XianleZeng/Project-in-Design-2024/Documents/Gear Slection/dimensions.png

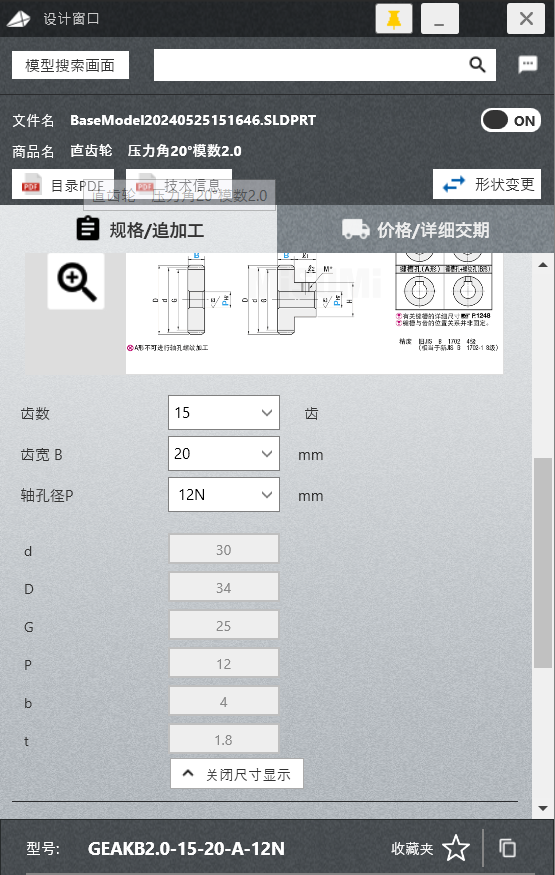
Documents/Gear Slection/dimensions.png
