XianleZeng/Project-in-Design-2024/Documents/Coupling/屏幕截图 2024-06-15 204243.png

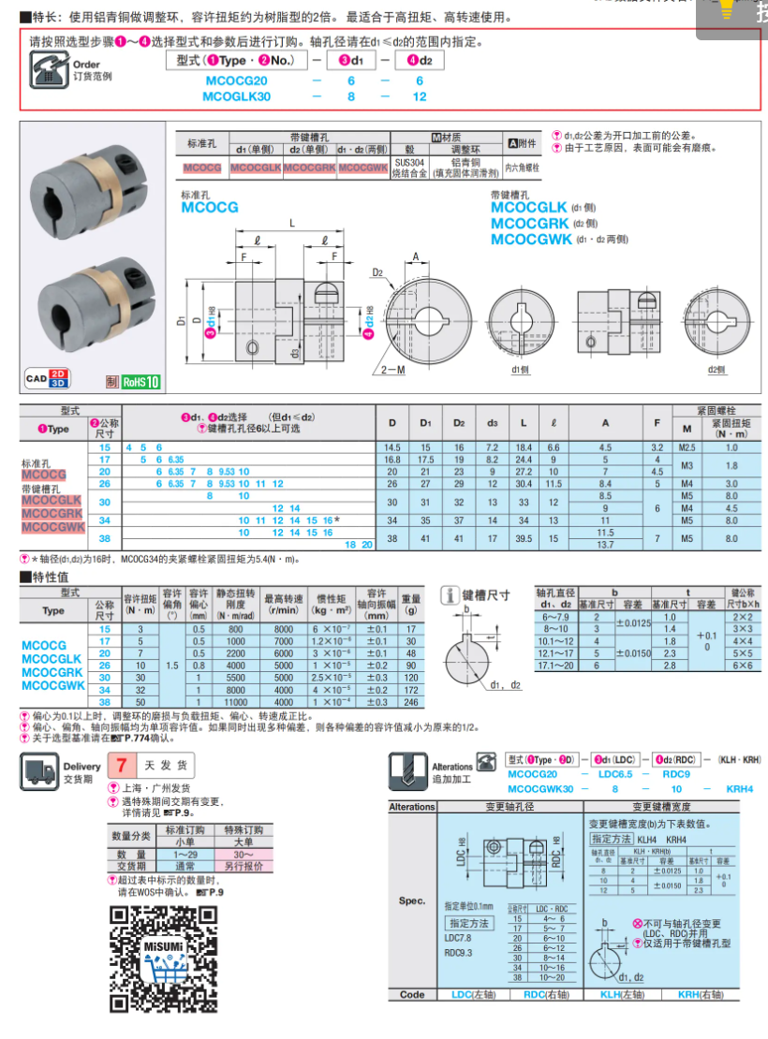
Documents/Coupling/屏幕截图 2024-06-15 204243.png
