XianleZeng/Project-in-Design-2024/Final Report.docx

Final Report – Durian Picker Machine

Yanlin Chen¹, Haojie Chen¹, Xianle Zeng¹

Abstract

# 1. Introduction

The purpose of this experiment

# 2. Concept Design

# 3. Technical Specification

# 4. Detail design

Solid modelling; Kinematics Simulation; Design Calculations (detail calc.s in appendix; reference to detail calc.s in main body of the report); FEA (description, figures of mesh(es), result contour plots, deflection plot) (group to decide how much in main body and how much in appendices and/or attached files.)

# 5. Results

# 6. Conclusion and recommendations

# 7. Reference

034057 - ADVANCED LAB IN MECH. ENG. - Spring 2024 ¹Guangdong Technion
