XianleZeng/Project-in-Design-2024/Documents/Scissor Design.docx

Scissor Design

Force analysis and dimension assume:

(Need solid work more accurate figure)

The dimension of scissor is L=250m, w=20mm, and h=10m

The force required when cutting durian branches at the bottom of scissor arm:

F=100N

And calculate the moment at the top of the scissor arm:

M_z =100[N]*250[mm]=25Nm

And then check for the yielding:

Choose the safety factor as

n = 1.5

The second moment of area:

I_z =(w^3 h)/12=(0.01^3 *0.02)/12

The first moment of area:

Q=(w/2)^2 *(h/2)=(0.02/2)(0.01/2)

Bending stress:

Normal: τ_x =-(M_z y)/(I_z)= -150 [MPa]

Shear: τ_(xz) =(VQ)/(I_z b)=3 [MPa]

And choose the 1030 HR steel for the scissor, the porosities of the material from Shigley’s book Table A-20:

The density of 1030 HR steel is 7.8g/cm^3

Since it’s a ductile material, choose Distortion-energy criterion:

σ^(') =(τ_x^2 +3τ_(xz)^2 )^(1/2) =(60^2 +3*3.75^2 )^(1/2) =150.089 [MPa]

σ^(') ≤(S_y)/(n_d)=260/1.5= 173.33 [MPa]

Thus, the beam will not yield.

From the solidwork, we get the volume of one scissor is 46713.47 mm^3 , so the mass of one scissor is:

m=ρ*V=7.8g/(cm^3)*46.713cm^3 =364.361g=0.364kg
