XianleZeng/Project-in-Design-2024/Documents/Shaft/Shaft_design.docx

Shaft Design

Force Analysis:

Free body diagram – as shown in the Figure4.1.1, Based on the FBD , the forces come from the scissors (in the x direction C_x =50N ) and gears (in the z direction D_z =850.34N ). The force on the gear comes from the motor driving the gear, and the reaction force is generated between the gears.

T=12.5Nm(From motor of one gear)

r=0.015m(From gear)

D_z =12.5/(0.98*0.015)(0.98 is the efficiency of motor)

The top end of the shaft on the right side of the diagram (point A) is connected to the motor, and there is a bearing at point B that secures the shaft on the right side. On the left side of the diagram, there are bearings at points A and B securing the shaft. Perform a force analysis on these two shafts.

On xy-plane:

{, A_x +B_x +C_x =0, C_x *AC+B_x *AG=0

A_x =12.5N B_x =37.5N

(in the left shaft the direction is along the positive x axis, in the right shaft the direction is along negative x axis)

On yz-plane

{, A_z +B_z +D_x =0, D_x *AD+B_Z *AG=0

A_x =425.17N B_x =425.17N

(in the left shaft the direction is along the negative z axis, in the right shaft the direction is along positive z axis)

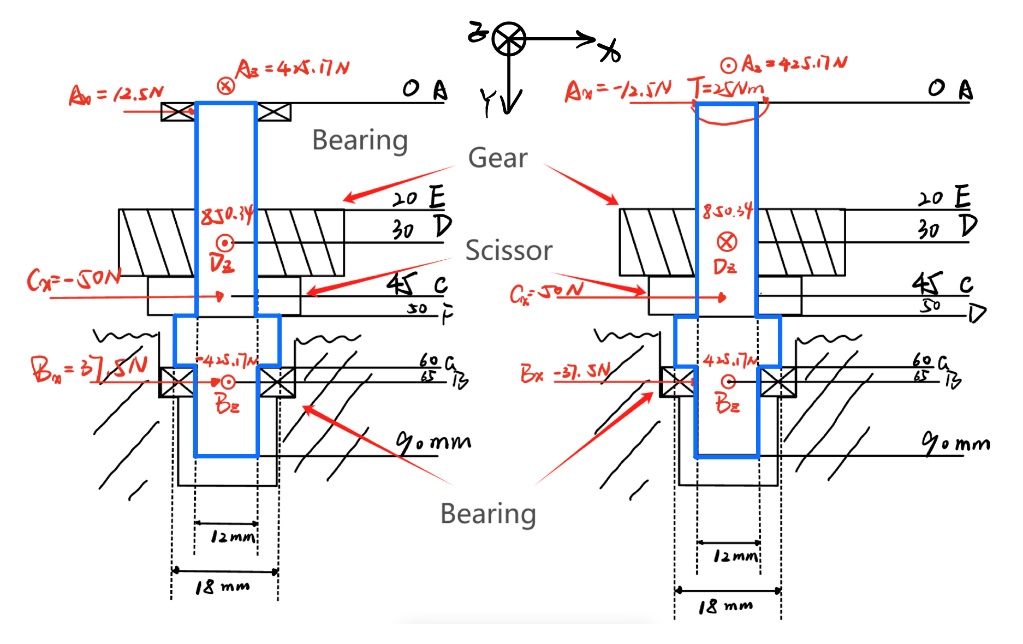
[picture p9: figure]

Figure4.1.1: Free body diagram of two shaft

After calculation of the shafts, we get the diagram of shear force and bending moment:

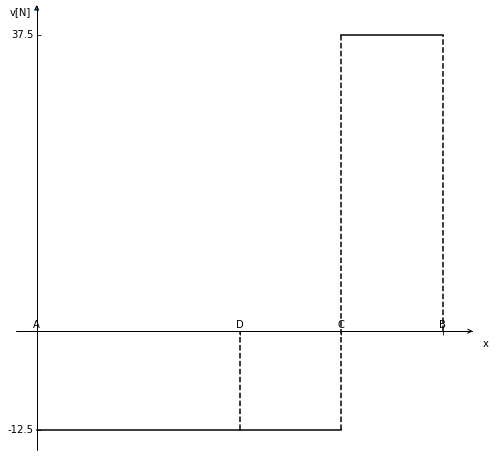
[picture p10: figure]
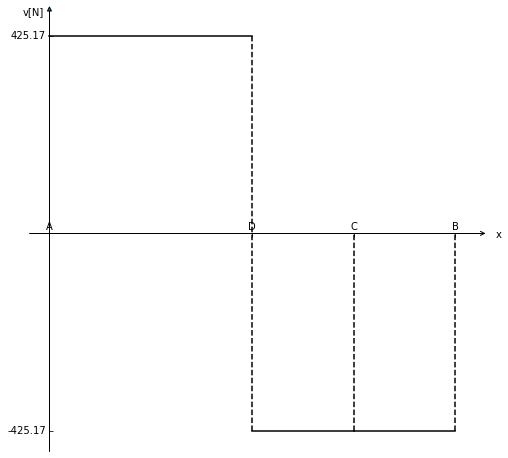
[picture p11: figure]

Figure4.1.2: shear force in xy plane | Figure4.1.3: shear force in yz plane

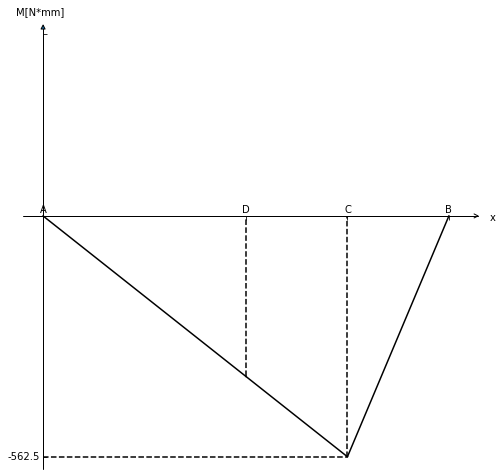
[picture p12: figure]
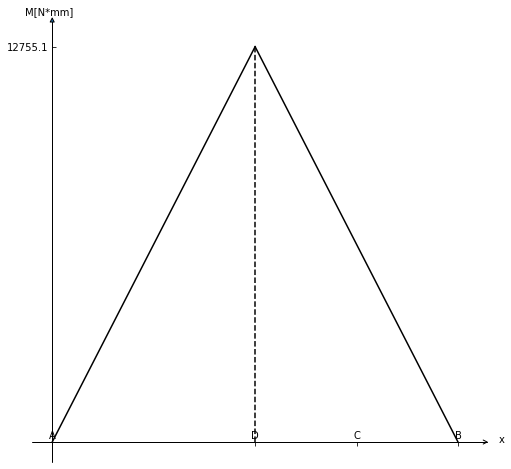
[picture p13: figure]

Figure4.1.4 Bending moment in xy plane | Figure4.1.5 Bending moment in yz plane

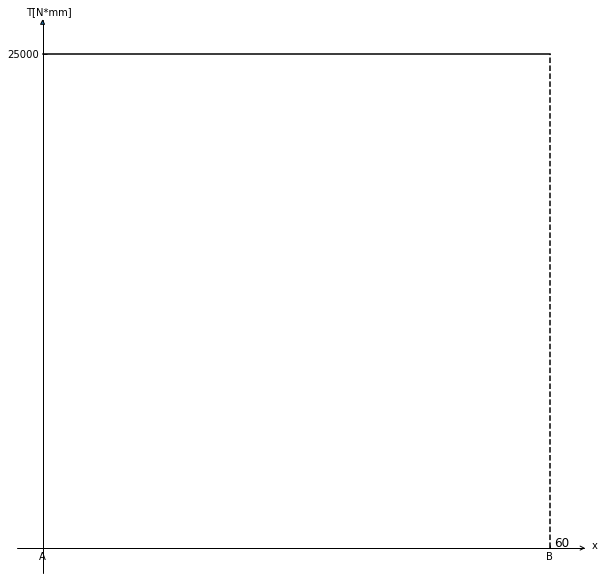
[picture p14: figure]
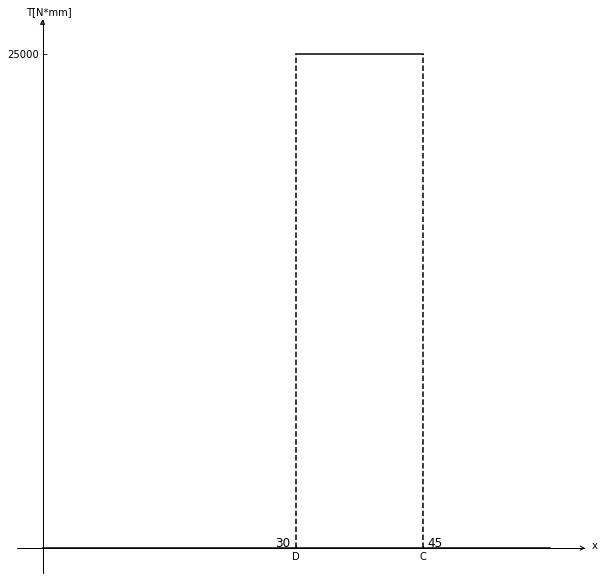
[picture p15: figure]

Figure4.1.5 Torque diagram of right shaft | Figure4.1.6 Torque diagram of left shaft

Check the shaft:

Choose the inexpensive steel, 1050CD steel, parameter is from Shigley’s book Table A-20:

S_(ut) =690MPa, S_y =580MPa

Start with point D, where the bending moment is high and there is the keyway

Forces at D:

M_(ax) = V_(AEz) ∙AE= 12755.1Nmm ; M_(mx) =0

M_(az) = V_(ACx) ∙AE= 375 Nmm ; M_(mz) =0

T_a =0Nmm; T_m =25000Nmm

Therefore,

M_a =√(M_(ax)^2 +M_(az)^2)= 12760.61 Nmm

M_m =T_a =0; T_m =25000Nmm

Based on the inner radius of the gear (12 mm), let’s design the diameter d to be 12 mm.

Assume the radius at the bottom of the keyway will be the standard r/d=0.02 , thereby

r=0.02(12)=0.24 mm

Choose the stress concentration factors from Shigley’s book

K_t =2.14 (Base on Shigley’s book Table 7-1)

K_(ts) =3.0 (Base on Shigley’s book Table 7-1)

q=0.52 (Base on Shigley’s book fig. 6-26)

q_s =0.5 (Base on Shigley’s book fig. 6-27)

From the Shigley’s book equation 6-32:

K_f =1+q*(K_t -1)=1.593

K_(fs) =1+q_s *(K_(ts) -1)=2

Then the modifying factors:

Surface factor from the Shigley’s book Table 6-2, from cold draw.

a=3.04 and b=-0.217

From equation 6-18:

k_a =aS_(ut)^b =0.731

Size factor from the Shigley’s book equation 6-19, due to the d=12mm, 7.62≤d≤51mm ,

k_b =1.24d^(-0.107) =0.95

Load factor from the Shigley’s book equation 6-25, and since there is not fluctuating axial loading, and the loading factor for torsion is already taken into account when using Mises Stress.

k_c =1

Temperature Factor the endurance limit is available or being estimated based on the ultimate strength at the operating temperature.

k_d =1

Reliability Factor

k_e =1

Estimating the Endurance Limit from equation 6-10, S_(ut) ≤1400MPa

S_e^(') =0.5S_(ut)

Finally, the endurance limit: From equation 6-17:

S_e =k_a k_b k_c k_d k_e S_e^(') =262.336MPa Use von Mises stresses from equation 7-4 and equation 7-5:

σ_a^(') =(σ_a^2 +3τ_a^2 )^(1/2) =[((32K_f M_a)/(πd^3))^2 +3((16K_(fs) T_a)/(πd^3))^2 ]^(1/2) =119.80MPa

σ_m^(') =(σ_m^2 +3τ_m^2 )^(1/2) =[((32K_f M_m)/(πd^3))^2 +3((16K_(fs) T_m)/(πd^3))^2 ]^(1/2) =255.244MPa

Then calculate the safety, using the Goodman Criterion from equation 6-41

n_f =((σ_a^('))/(S_e)+(σ_m^('))/(S_(ut)))^(-1) =1.15

And the yielding safety factor:

n_y =(S_y)/(σ_(max))=(S_y)/(σ_a^(') +σ_m^('))=1.55

At point E, there is a ring we will look up data for a specific retaining ring to obtain K_f and K_(fs) more accurately.

With a quick online search of a retaining ring specification appropriate groove specifications for a retaining ring for a shaft diameter of 11.5mm are obtained as follows: width, a=1mm; depth, 0.25mm; and corner radius at the bottom of grove, r=0.13mm

Just to the up of point E.

Forces at E:

M_(ax) = V_(AEz) ∙AE= 8503.4Nmm ; M_(mx) =0

M_(az) = V_(ACx) ∙AE= 25 Nmm ; M_(mz) =0

T_a =0Nmm; T_m =25000Nmm

Therefore,

M_a =√(M_(ax)^2 +M_(az)^2)= 8507.07 Nmm

M_m =T_a =0; T_m =25000Nmm

And

r/t=0.52

a/t=4

Choose the stress concentration factors from Shigley’s book

K_t =2.9 (Base on Shigley’s book fig.A-15-16)

K_(ts) =1.3 (Base on Shigley’s book fig.A-15-17)

q=0.51 (Base on Shigley’s book fig. 6-26)

q_s =0.55 (Base on Shigley’s book fig. 6-27)

From the Shigley’s book equation 6-32:

K_f =1+q*(K_t -1)=1.532

K_(fs) =1+q_s *(K_(ts) -1)=1.320

Then the modifying factors:

Surface factor from the Shigley’s book Table 6-2, from cold draw.

a=3.04 and b=-0.217

From equation 6-18:

k_a =aS_(ut)^b =0.731

Size factor from the Shigley’s book equation 6-19, due to the d=12mm, 7.62≤d≤51mm ,

k_b =1.24d^(-0.107) =0.95

Load factor from the Shigley’s book equation 6-25, and since there is not fluctuating axial loading, and the loading factor for torsion is already taken into account when using Mises Stress.

k_c =1

Temperature Factor the endurance limit is available or being estimated based on the ultimate strength at the operating temperature.

k_d =1

Reliability Factor

k_e =1

Estimating the Endurance Limit from equation 6-10, S_(ut) ≤1400MPa

S_e^(') =0.5S_(ut)

Finally, the endurance limit: From equation 6-17:

S_e =k_a k_b k_c k_d k_e S_e^(') =239.742MPa

Use von Mises stresses from equation 7-4 and equation 7-5:

σ_a^(') =(σ_a^2 +3τ_a^2 )^(1/2) =[((32K_f M_a)/(πd^3))^2 +3((16K_(fs) T_a)/(πd^3))^2 ]^(1/2) =57.82MPa

σ_m^(') =(σ_m^2 +3τ_m^2 )^(1/2) =[((32K_f M_m)/(πd^3))^2 +3((16K_(fs) T_m)/(πd^3))^2 ]^(1/2) =168.46MPa

Then calculate the safety, using the Goodman Criterion from equation 6-41

n_f =((σ_a^('))/(S_e)+(σ_m^('))/(S_(ut)))^(-1) =2.06

And the yielding safety factor:

n_y =(S_y)/(σ_(max))=(S_y)/(σ_a^(') +σ_m^('))=2.56

And then check for point C, here the bending moment is high and there is a stress concentration of the shoulder.

Forces at C:

M_(az) = V_(ACx) ∙AC= 562.5 Nmm ; M_(mx) =0

M_(ax) = V_(DBx) ∙AC+12755.1= 6377.55 Nmm ; M_(mz) =0

T_a =0; T_m =25000Nmm

Therefore,

M_a =√(M_(ax)^2 +M_(az)^2)= 6402.31 Nmm

M_m =T_a =0; T_m =25000Nmm

Based on the inner radius of the gear (12 mm), let’s design the diameter d to be 12 mm.

Next, check for failure:

Choose diameter ratio for the shoulder: D/d = 1.5, thereby

D=1.5(12)=18 mm

Select standard value D = 18 mm.

Check if estimates were acceptable:

D/d=1.5→OK

Choose fillet ratio r/d=0.1 for well-rounded shoulder, based on Shigley’s book [Table 7-1].

So the fillet radius is r=0.1*d=1.2mm .

Choose the stress concentration factors from Shigley’s book

K_t =1.7 (Base on Shigley’s book fig. A-15-9)

K_(ts) =1.4 (Base on Shigley’s book fig. A-15-8)

q=0.76 (Base on Shigley’s book fig. 6-26

q_s =0.8 (Base on Shigley’s book fig. 6-27

From the Shigley’s book equation 6-32:

K_f =1+q*(K_t -1)=1.532

K_(fs) =1+q_s *(K_(ts) -1)=1.319

Then the modifying factors:

Surface factor from the Shigley’s book Table 6-2, from cold draw.

a=3.04 and b=-0.217

From equation 6-18:

k_a =aS_(ut)^b =0.731

Size factor from the Shigley’s book equation 6-19, due to the d=12mm, 7.62≤d≤51mm ,

k_b =1.24d^(-0.107) =0.95

Load factor from the Shigley’s book equation 6-25, and since there is not fluctuating axial loading, and the loading factor for torsion is already taken into account when using Mises Stress.

k_c =1

Temperature Factor the endurance limit is available or being estimated based on the ultimate strength at the operating temperature.

k_d =1

Reliability Factor

k_e =1

Estimating the Endurance Limit from equation 6-10, S_(ut) ≤1400MPa

S_e^(') =0.5S_(ut)

Finally, the endurance limit: From equation 6-17:

S_e =k_a k_b k_c k_d k_e S_e^(') =239.742MPa Use von Mises stresses from equation 7-4 and equation 7-5:

σ_a^(') =(σ_a^2 +3τ_a^2 )^(1/2) =[((32K_f M_a)/(πd^3))^2 +3((16K_(fs) T_a)/(πd^3))^2 ]^(1/2) =57.816MPa

σ_m^(') =(σ_m^2 +3τ_m^2 )^(1/2) =[((32K_f M_m)/(πd^3))^2 +3((16K_(fs) T_m)/(πd^3))^2 ]^(1/2) =168.46MPa

Then calculate the safety, using the Goodman Criterion from equation 6-41

n_f =((σ_a^('))/(S_e)+(σ_m^('))/(S_(ut)))^(-1) =2.061

And the yielding safety factor from equation 7-7:

n_y =(S_y)/(σ_(max))=(S_y)/(σ_a^(') +σ_m^('))=2.563

Finally, let us check for deflection:

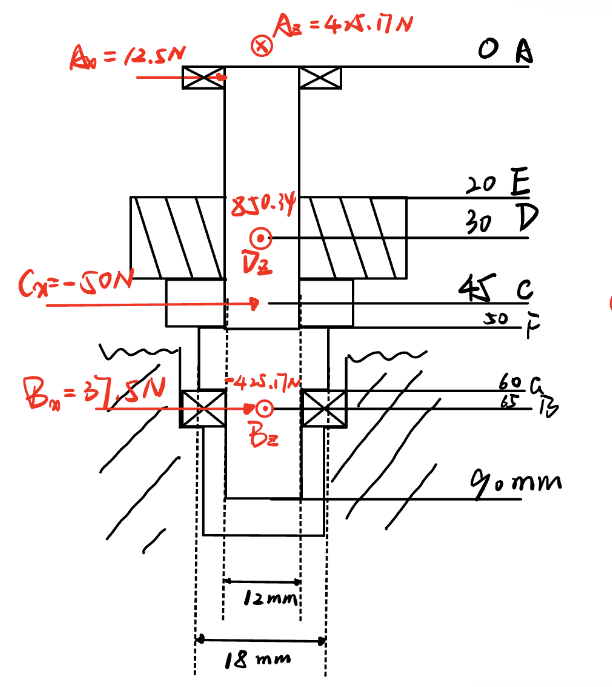
[picture p16: figure]

For simplification, let’s assume diameter from F to G is equal to OF, this is more conservative.

In xy plane, For boundary condition:

v_(AC) (0)=0

v_(AC) (at C)=v_(CB) (at C)=0

v_(AC)^(') (at C)=v_(CB)^(') (at C)

v_(AB) (at B)=0

Integrate the moment functions:

EI_1 (dv_1)/(dx)=∫ M_1 dx+C_1

EI_2 (dv_2)/(dx)=∫ M_2 dx+C_2

EI_1 v_1 =∫ EI_1 (dv_1)/(dx)dx+C_3

EI_2 v_2 =∫ EI_2 (dv_2)/(dx)dx+C_4

And d_1 =d_2 =12mm , I_1 =(πd_1^4)/64 and I_2 =(πd_2^4)/64

So, there is four equations and four unknowns, use python to solve:

v_1 =-9.9841*10^(-9) *x^3 + 2.0218*10^(-5) *x

v_2 =2.9952*10^(-8) *x^3 - 5.3914*10^(-6) *x^2 + 0.0002628*x - 0.00283

(dv_1)/(dx)= - 2.9952*10^(-8) *x^2 +2.0217*10^(-5)

(dv_2)/(dx)=8.9857*10^(-8) *x^2 - 1.0783*10^(-5) *x + 0.00026

In xz plane, For boundary condition:

v_(AD) (0)=0

v_(AD) (at D)=v_(DB) (at D)=0

v_(AD)^(') (at D)=v_(AD)^(') (at D)

v_(AB) (at B)=0

Therefore, use python to solve:

v_1 =3.39596041*10^(-7) *x^3 - 0.0003056*x

v_2 =-3.39596*10^(-7) *x^3 + 6.11272*10^(-5) *x^2 - 0.002139*x - 0.01833

(dv_1)/(dx)=1.01878812*10^(-6) *x^2 - 0.0003056

(dv_2)/(dx)=-1.01878812*10^(-6) *x^2 + 0.00012225*x - 0.00213946

Table4.1.1: Slope and Deflection Values at key Locations

Point of interest | XY Plane | XZ Plane | Total
Gear slope (D) | 6.739284514*10^(-6) [rad] | 0.00061127 [rad] | 0.00061131[rad]
Bearing slope (B) | 6.065356062*10^(-5) [rad] | 0.00152818 [rad] | 0.00152938[rad]
Gear deflection (D) | 0.00033[mm] | 0.000169[mm] | 0.00037[mm]

The deflections and slopes at points of interest are obtained from the calculation, and combined with orthogonal vector addition, that is, (δ_(XY)^2 +δ_(XZ)^2 )^(1/2) . Results are shown in Table4.1.1 And according to the guidelines in Table 7-2 in Shigley’s book. It is satisfied for the requirement.
