XianleZeng/Project-in-Design-2024/Documents/Beam/Beam_Design.docx

Beam Design:

Free body diagram:

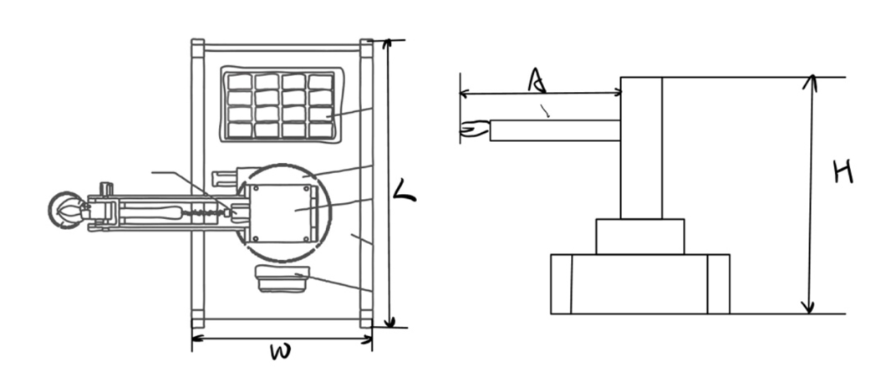
[picture p17: figure]

Force analysis:

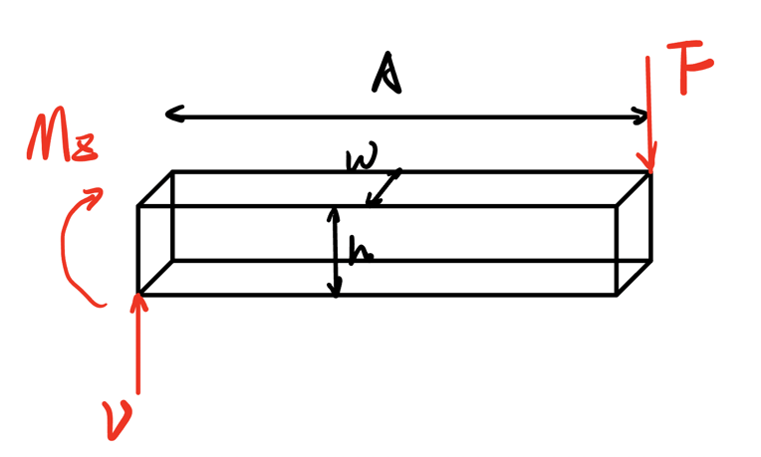
[picture p18: figure]

F_(mass) =F_(box) +F_(motor) +F_(shaft+gear+scissor) =185.423 [N]

To be more conservative, we magnify it by a factor γ=1.5 .

F=γF_(mass) =185.423*1.5=278.134 [N]

Force Diagram:

Point D is the critical point since the bending moment at this point is highest and there is a stress concentration of the guide rail.

The internal moment and the shear force at the critical point:

V = F

M_z =V*A=417.201 [Nm]

Let’s choose G10300 HR steel as the material from Shigley’s book Table A-20, the properties:

Assume the dimension of the beam:

Thickness: h = 0.25 m

Width: b = 0.25 m

Let’s check for the yielding:

Choose the safety factor as

n = 1.3

Bending stress:

Normal: τ_x =-(M_z y)/(I_z)= -160.205 [MPa]

Shear: τ_(xz) =(VQ)/(Ib)=6.675 [MPa]

Since it’s a ductile material, choose Distortion-energy criterion:

σ^(') =(τ_x^2 +3τ_(xz)^2 )^(1/2) = 160.344 [MPa]

σ^(') ≤(S_y)/(n_d)=260/1.3= 200 [MPa]

Thus, the beam will not yield.
