XianleZeng/Project-in-Design-2024/Final/Presentation.pptx

## Durian Picker Mechine

034371 - PROJECT IN DESIGN FOR MANUFACTURING - Spring 2024
Yanlin Chen; Haojie Chen; Xianle Zeng

## Slide 2

Introduction

## Slide 3

Concept Design

## Slide 4

Technical Specification

## Slide 5

Detail Design

## Slide 6

Detail Design: Cutter

## Slide 7

Detail Design: Gear

## Slide 8

Detail Design: …

## Slide 9

Detail Design: …

## Slide 10

Results

## Slide 11

Conclusion and Recommendations
