XianleZeng/Project-in-Design-2024/Documents/Gear Slection/Spur-Gear Selection.docx

3.10. Gear Selection

Spur Gear Selection Flow Chart

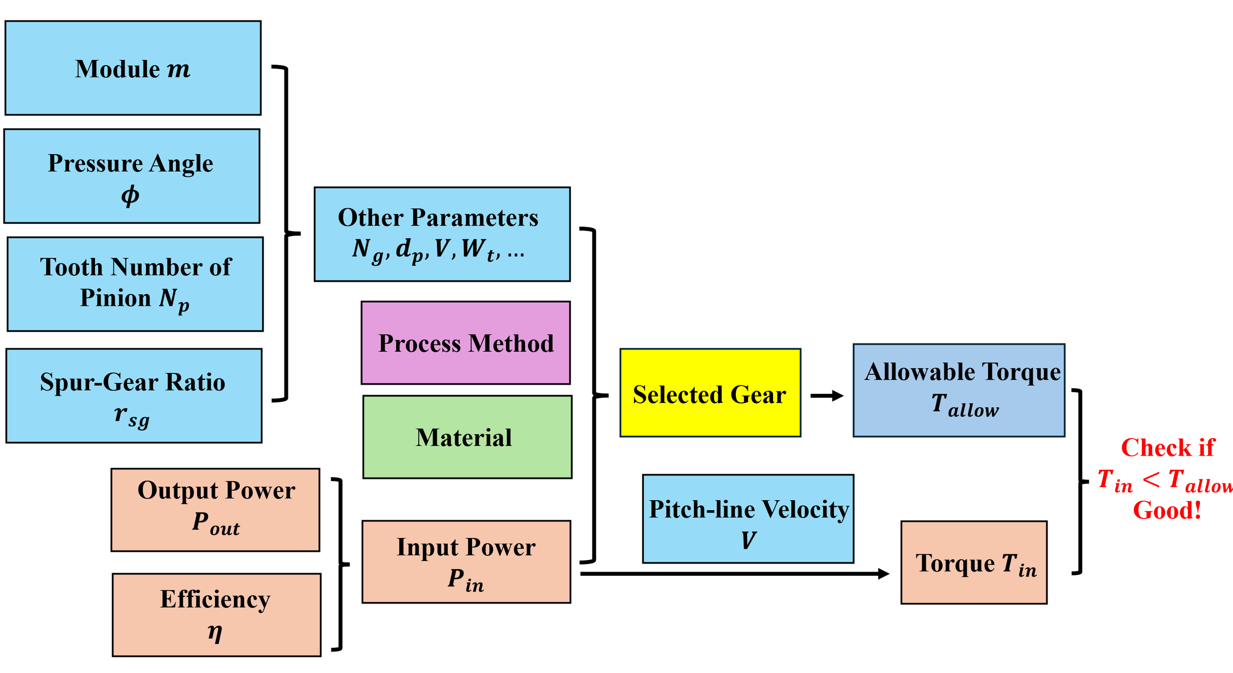
[picture p32: figure]

Figure 3.10.1: Durian picker machine end-effector spur-gear selection flow chart.

Power Relationships of Spur Gear and End-effector

Since we lack an exact cut-off force value about the durian branch, here we assign a significantly sufficient value 50N to the cut-off force F_(cut) ensuring that desired motion is achieved. The durian picking task is not strict with the speed requirements of the end-effectors, therefore we select a nice angular speed to fit our need, which represents the end-effector rotating π/2 rads in 1 seconds, i.e., w=(π/2)/1=1.570796 rads/sec . Length of end-effector is l=0.25 m . Power applied on the end-effector is 19.634954 W . Considering that power losses between pinion, and that gear and its efficiency generally varies between 0.98~1 , we choose an efficiency coefficient η=0.98 . Thus, the power subjected to the pinion is known as 20.035667 W .

, P_(out) =F_(cut) lw= 19.634954 W

, P_(in) =(P_(out))/η=20.035667 W

Teeth Number Determination of Spur Pinion and Gear

When two gears are in mesh, it is possible that an involute portion of one will contact a non-involute portion of the other gear. This phenomenon is known as "interference" and occurs when the number of teeth on the smaller of the two meshing gears is less than a required minimum.

The Determination of Teeth Number of Spur Pinion Without Interference

To avoid the interference between gears, it is necessary to determine the smallest teeth number of spur pinion (refer to Shiley eq.13-10), where k=1 for full-depth teeth and ϕ=20° is the pressure angle we decide. Then we find that the smallest teeth number of the spur pinion without interference is 13. For safety consideration, a considerable teeth number of gears is more welcome in our design. Therefore, we choose the teeth number of spur-gear is N_p =15 .

, N_(p,min) =(2k)/(3sin^2 (ϕ))(1+√(1+3sin^2 (ϕ)))=(2∙1)/(3sin^2 (20°))(1+√(1+3sin^2 (20°)))=12.3=13#

N_p =15

The Determination of Teeth Number of Gear Without Interference

Since the teeth number of gear cannot be infinite, the maximum teeth number of gear is determined with the help of Shigley eq.13-12.

N_(G,max) =(N_p^2 sin^2 ϕ-4k^2)/(4k-2N_p sin^2 ϕ)=(15^2 sin^2 20°-4(1)^2)/(4(1)-2(15)sin^2 20°)=45

It means that if the teeth number of gear does not exceed 45, then the selected gear will not encounter interference phenomena. Since we set the spur-gear ratio is 1, the teeth number of the gear should be the same as pinion’s, i.e., 15.

N_G =15

Theoretical Torque Calculation

Before we realize the theoretical torque applied to the pinion, we need to know the pitch-line velocity V and tangent force W_t between the gearset.

Pitch-line Velocity

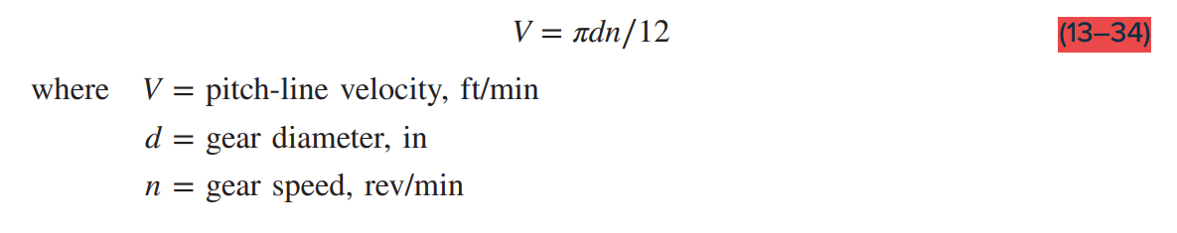
[picture p33: figure]

d_p =N_p m=15(2)=30 mm

V=1/1000∙(πd_p)/w=1/1000∙(π(30))/1.570796=0.023562 m/sec

Tangent Force

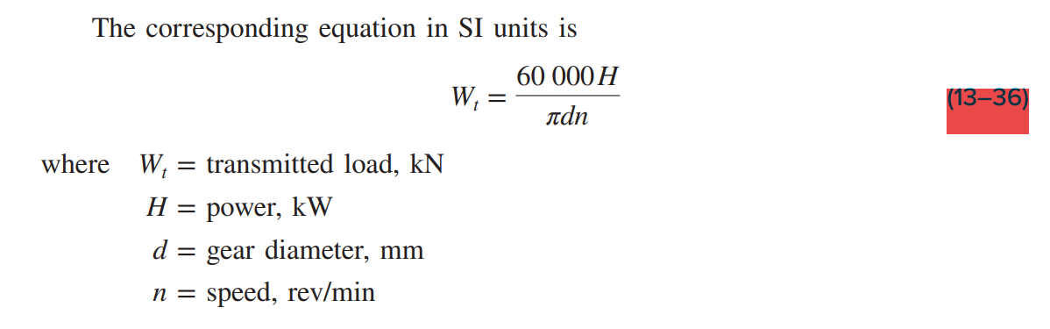
[picture p34: figure]

W_t =(P_(in))/V=20.035667/0.023562=850.340136 N

Theoretical Torque Applied to the Pinion

T_(theo) =W_t (d_p)/2=850.340136∙((30/1000)/2)=12.755102 Nm

Spur-Gear Selection

A gearset (GEAKB2.0-15-20-A-12N) provided by a Japanese company, MiSUMi, fit our need. Here are all relevant parameters. m [mm], N_T , W_T [mm] and T_(allow) [Nm] represent module, teeth number, teeth width, and allowable torque respectively.

Table 3.10.1: Spur-Gear Parameters.

m [mm] | N_T | W_T [mm] | Key Size | Material | Specific Process | T_(allow) [Nm]
2 | 15 | 20 | 12N | S45C | / | 28.65

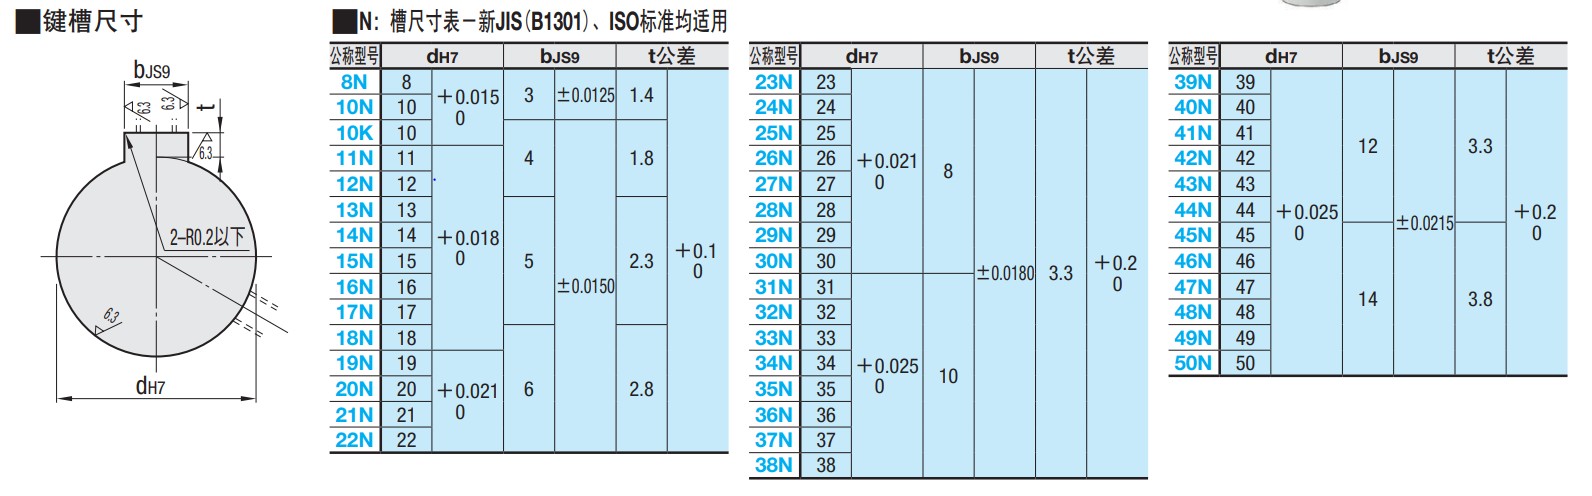
[picture p35: figure]

Figure 3.10.2: Tolerance of the keyway.

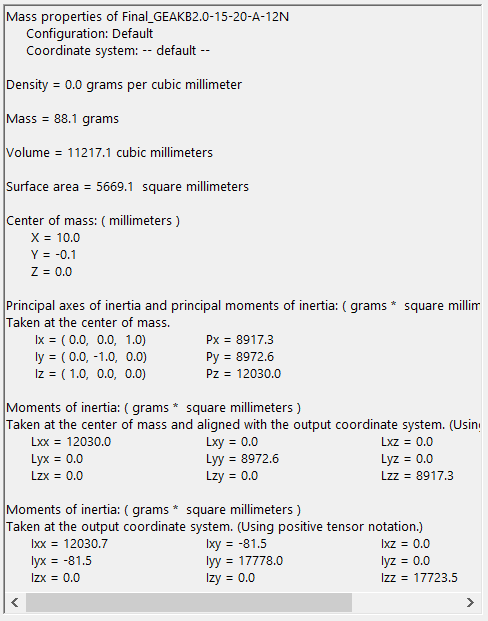
[picture p36: figure]

Figure 3.10.3: Other information about the gear.

Examine the Failure of Gearset

Refer to Table 3.10.1, we know the allowable torque T_(allow) tested in experiment from MiSUMi company, then we can compare the allowable torque T_(allow) and the theoretical torque we calculated T_(theo) . If the theoretical torque T_(theo) is smaller than the allowable torque T_(allow) , we successfully select the gear. Otherwise, we need to choose a new one.

T_(theo) =12.755102 Nm<28.65 Nm=T_(allow)

We successfully chose a desired gear, which is GEAKB2.0-15-20-A-12N!

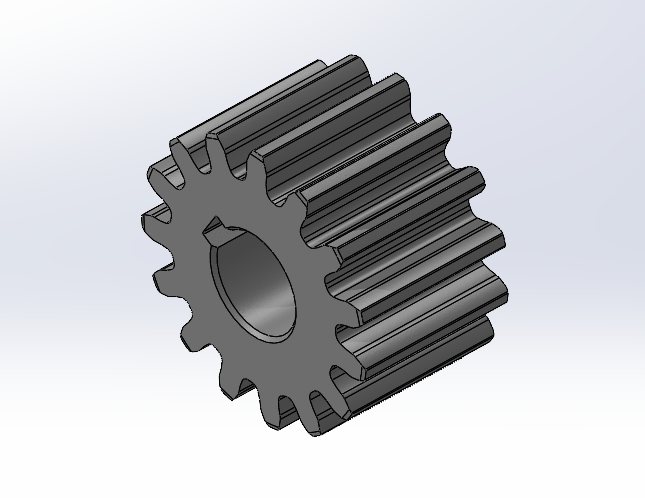
[picture p37: figure]

Figure 3.10.4: Spur-Gear GEAKB2.0-15-20-A-12N (MiSUMi).
