XianleZeng/Project-in-Design-2024/Documents/Bearing Selection/Bearing Selection.docx

Bearing Selection:

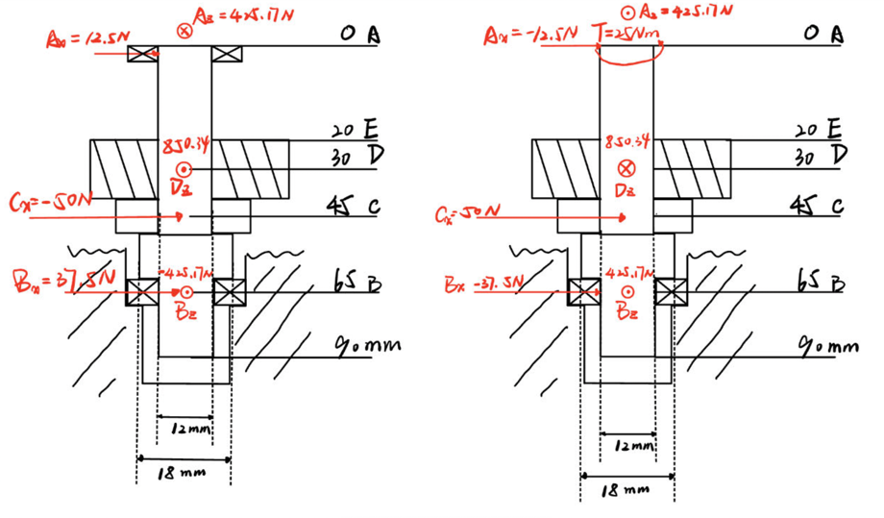
[picture p38: figure]

Figure 1 Shaft Layout

For the bearing at B on the left shaft:

1. Performance and operating condition:

Table 1 Performance and operating condition for the bearing at B on the left shaft

Radical Force ( F_r =√(B_x^2 +B_z^2) ) | 426.82 [N]
Axial Force ( F_a ) | 7.487 [N]
Speed | 15 [rpm]
Operating Condition | 50 [degree]
Required rating life* | 20000 [h]

* Let’s say the machine operate 40 h for one week and operate 48 weeks per year. If we want it to work for 10 years, then the total life is (48)(40)(10)= 19200≈20000 h .

2. Bearing type and arrangement:
- Locating bearing is used since the bearing B need to carry the weight of the shaft, the gear and the cutter.
- Deep groove ball bearings are selected because they have the capability to carry both axial and radical force.
3. Bearing Size:

The inner radius of the shaft is 12 mm, thereby the inner radius of the bearing should align with it. Then, choose the 6201 deep groove ball bearing from SKF company.

4. Technical Specification:

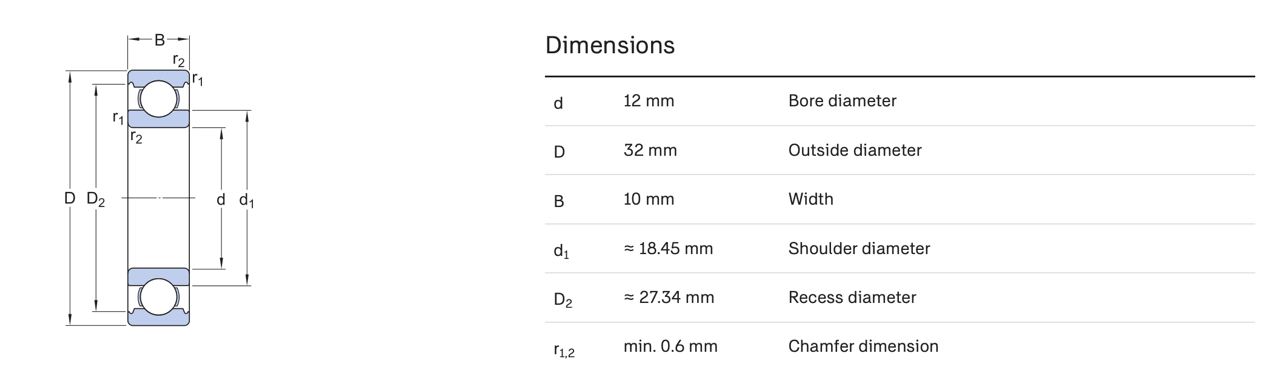
[picture p39: figure]

Figure 2 Technical specification of 6201 deep groove ball bearing from SKF company

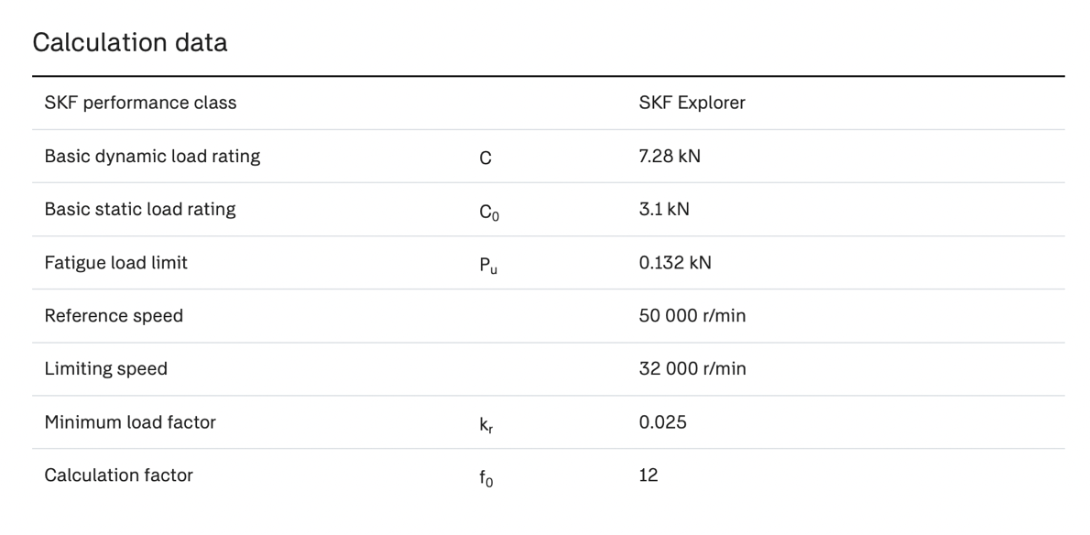
[picture p40: figure]

Figure 3 Calculation data of 6201 deep groove ball bearing from SKF company

5. Basic rating life:

From the data sheet for 6201 deep groove ball bearing, the calculation factor:

f_0 =12

(f_0 F_a)/(C_0)=(12∙0.42682)/3.1=1.6522

From Table 10, P257, SKF handbook, e = 0.34, and:

(F_a)/(F_r)=0.0175<e

According to Page 254 in SKF handbook,

P=F_A =426.82 [N]

L_(10h) =((10^6)/(60n))(C/P)^p =((10^6)/(60(15)))(7.28/0.43)^(10/3) =398,4000 [h]> 20000[h]

which satisfies our requirement.

6. Lubrication:

Input Values:

d_m =0.5(12+32)=22 [mm]

nd_m =15∙22=330 [mm/min]

n= 15 [rpm]

C/P= 7.28/0.43=16.93

From SKF handbook, Table 1, Page 113,

b_f =1

The nd_m limit is 100000, which is greater than 210.

Grease selection criteria:

- Temperature: 50 -> M
- Speed: nd_m =330 -> L
- Load: C/P = 16.93 -> L

From the SKF bearing grease selection chart, page 124, LGWM2 grease is selected since the bearing operates at low speed.

nd_m b_f = 330

From SKF handbook, Diagram 2 Page 112, the relubrication intervals at operating temperatures of 70 °C is:

t_(f@70℃) =25000 [h] <20000 [h]

This satisfies the requirement.

For the bearing at B on the right shaft:

1. Performance and operating condition:

Table 2 Performance and operating condition for the bearing at B on the right shaft

Radical Force ( F_B =√(B_x^2 +B_z^2) ) | 426.82 [N]
Axial Force | 0 [N]
Speed | 15 [rpm]
Operating Condition | 50 [degree]
Required rating life* | 20000 [h]

2. Bearing type and arrangement:
- Non-locating bearing is used since the bearing A only carry the radical load.
- Needle bearing is used.
3. Bearing Size:

The inner radius of the shaft is 12 mm, thereby the inner radius of the bearing should align with it. Then, choose the HK 1210 E needle roller bearing from SKF company.

4. Technical Specification:

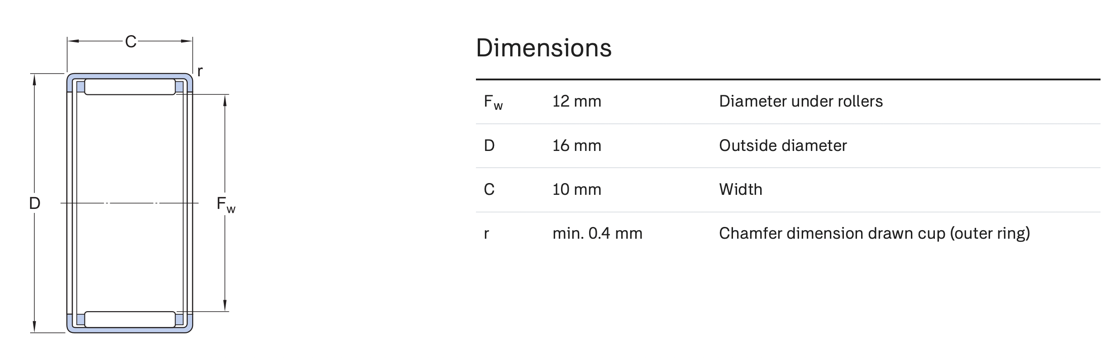
[picture p41: figure]

Figure 4 Technical specification of HK 1210 E needle roller bearing from SKF company.

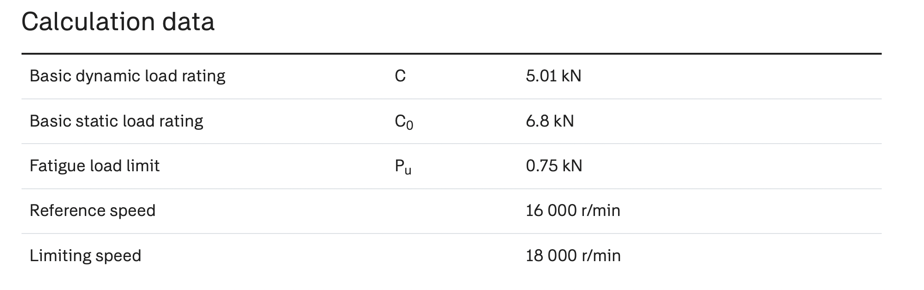
[picture p42: figure]

Figure 5 Calculation data of HK 1210 E needle roller bearing from SKF company.

5. Basic rating life:

P=F_A =426.82 [N]

L_(10h) =((10^6)/(60n))(C/P)^p =((10^6)/(60(15)))(5.01/0.43)^(10/3) =398,4000 [h]> 20000[h]

which satisfies our requirement.

6. Lubrication:

Input Values:

d_m =0.5(12+16)=14 [mm]

nd_m =15∙14=210 [mm/min]

n= 15 [rpm]

C/P= 5.01/0.43=11.65

From SKF handbook, Table 1, Page 113,

b_f =3

The nd_m limit is 100000, which is greater than 210.

Grease selection criteria:

- Temperature: 50 -> M
- Speed: nd_m =210 -> L
- Load: C/P = 11.65 -> M

From the SKF bearing grease selection chart, page 124, LGEV2 grease is selected since the bearing operates at low speed.

nd_m b_f = 630

From SKF handbook, Diagram 2 Page 112, the relubrication intervals at operating temperatures of 70 °C is:

t_(f@70℃) =10050 [h]

Since the operating temperature in this project is 50℃ , based on SKF handbook, table 2, we need to adjust the interval by double it, therefore,

t_(f@50℃) =20100 [h]<20000 [h]

This satisfies the requirement.

For the bearing at A on the left shaft:

1. Performance and operating condition:

Table 3 Performance and operating condition for the bearing at A on the left shaft

Radical Force ( F_A = √(A_x^2 +A_y^2) ) | 425.35 [N]
Axial Force | 0 [N]
Speed | 15 [rpm]
Operating Condition | 50 [degree]
Required rating life* | 20000 [h]

* Let’s say the machine operate 40 h for one week and operate 48 weeks per year. If we want it to work for 10 years, then the total life is (48)(40)(10)= 19200≈20000 h .

Since the performance and operating condition is similar with the Bearing B of the right shaft with a lower radical force, we can use the same bearing here. Therefore, we choose HK 1210 E needle roller bearing from SKF company for this shaft.
