XianleZeng/Project-in-Design-2024/Documents/Gear Slection/dataset1.PNG

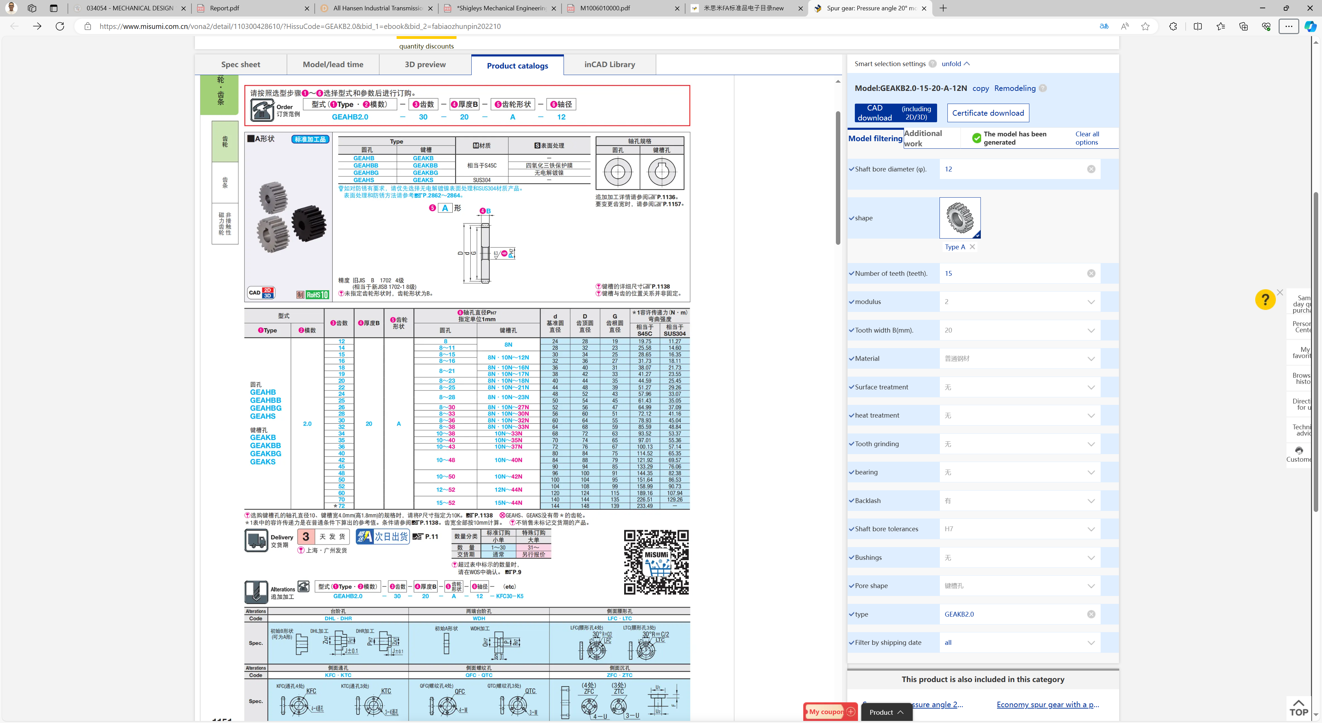
Documents/Gear Slection/dataset1.PNG
