XianleZeng/Project-in-Design-2024/Documents/Gear Slection/Flow Chart.PNG

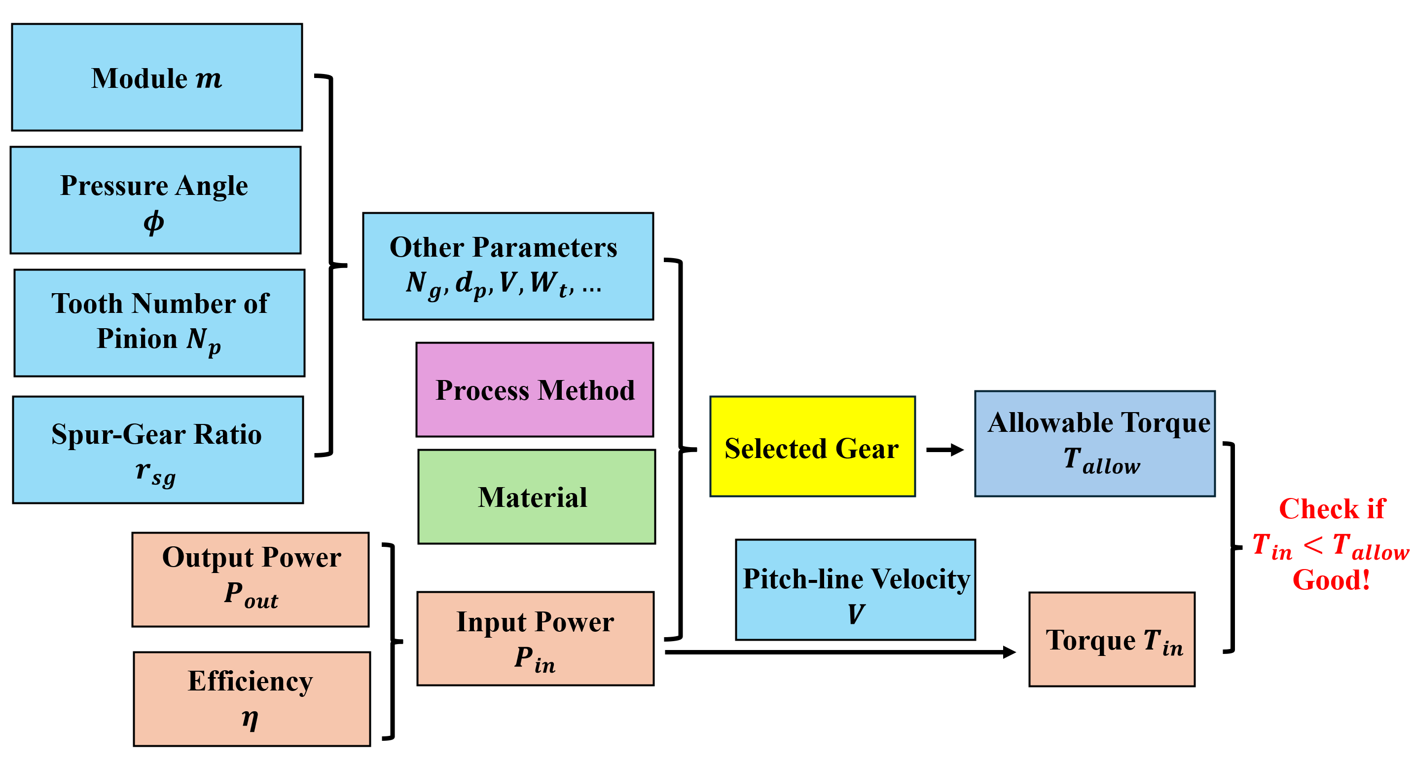
Documents/Gear Slection/Flow Chart.PNG
