XianleZeng/Project-in-Design-2024/Documents/Gear Slection/Gear_density_volume_mass.PNG

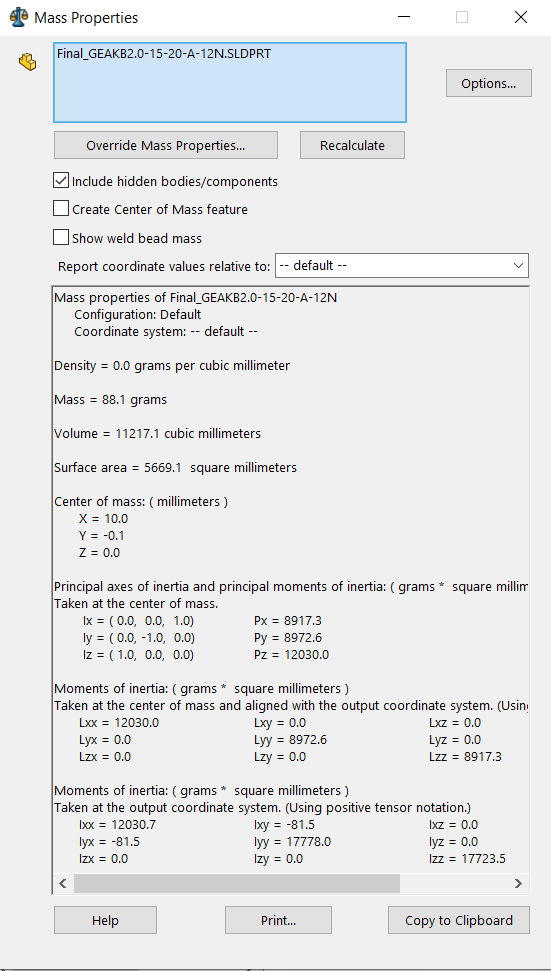
Documents/Gear Slection/Gear_density_volume_mass.PNG
