XianleZeng/Project-in-Design-2024/Documents/Gear Slection/size_symbol.png

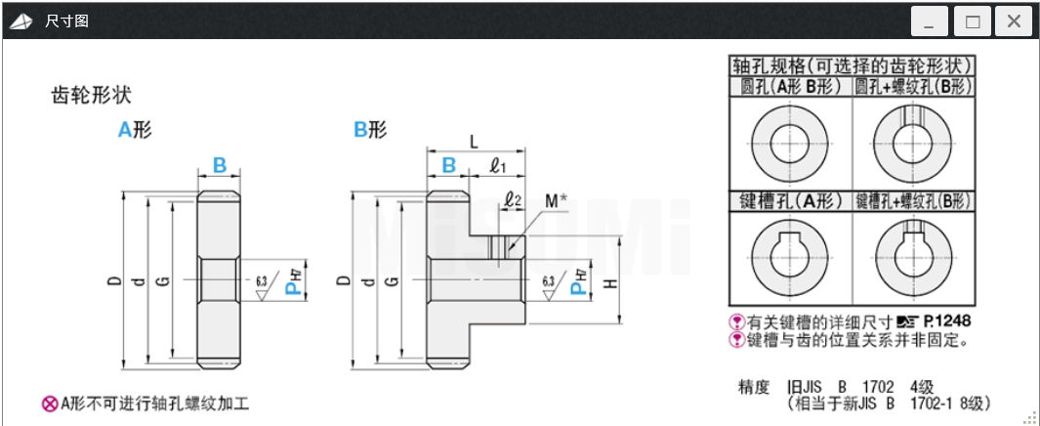
Documents/Gear Slection/size_symbol.png
