XianleZeng/Project-in-Design-2024/Documents/Gear Slection/standard and commonly used tooth systems for spur gears.png

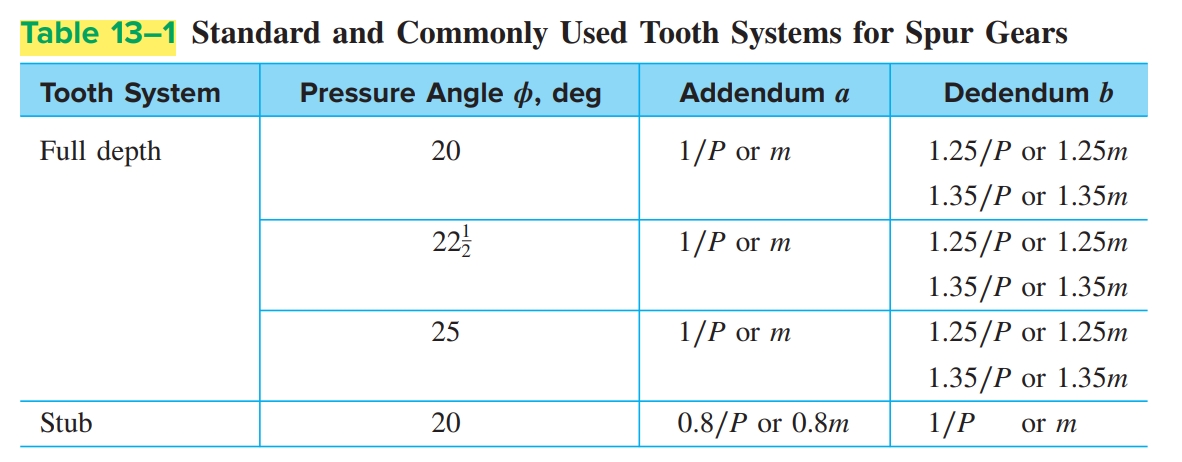
Documents/Gear Slection/standard and commonly used tooth systems for spur gears.png
