XianleZeng/Project-in-Design-2024/Documents/Gear Slection/tooth number_pinion_eq13-10.PNG

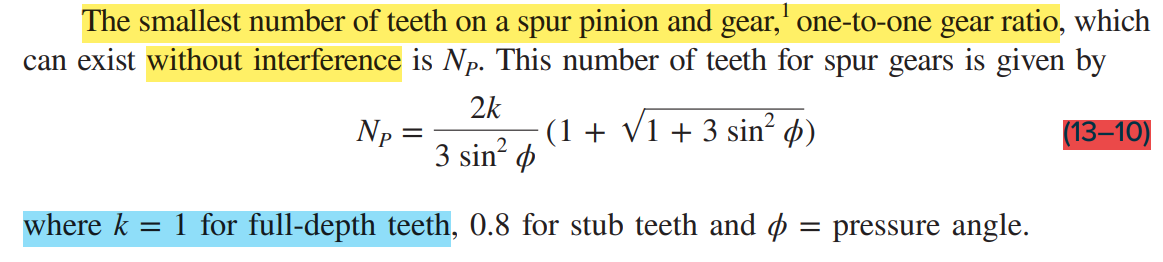
Documents/Gear Slection/tooth number_pinion_eq13-10.PNG
