XianleZeng/Project-in-Design-2024/Documents/Gearhead+Motor/Gearbox/Screen Shot 2024-05-25 at 11.29.21.png

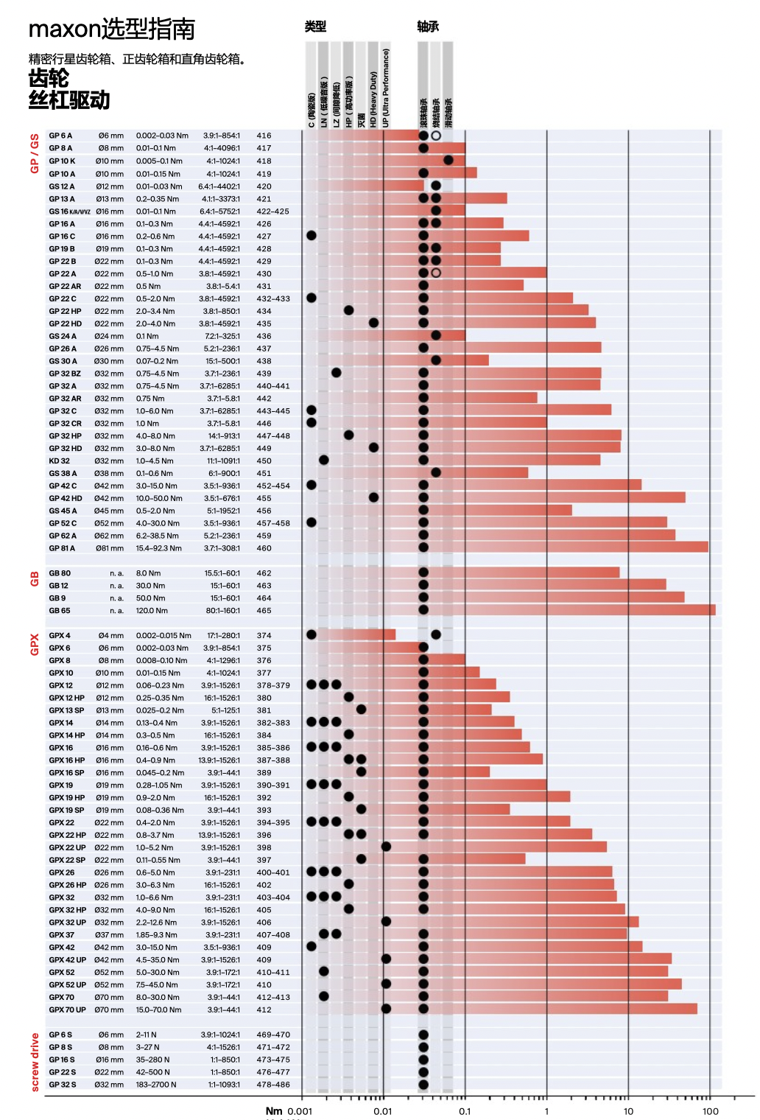
Documents/Gearhead+Motor/Gearbox/Screen Shot 2024-05-25 at 11.29.21.png
