XianleZeng/Project-in-Design-2024/SW/Assemble/Shaft_connection.SLDASM

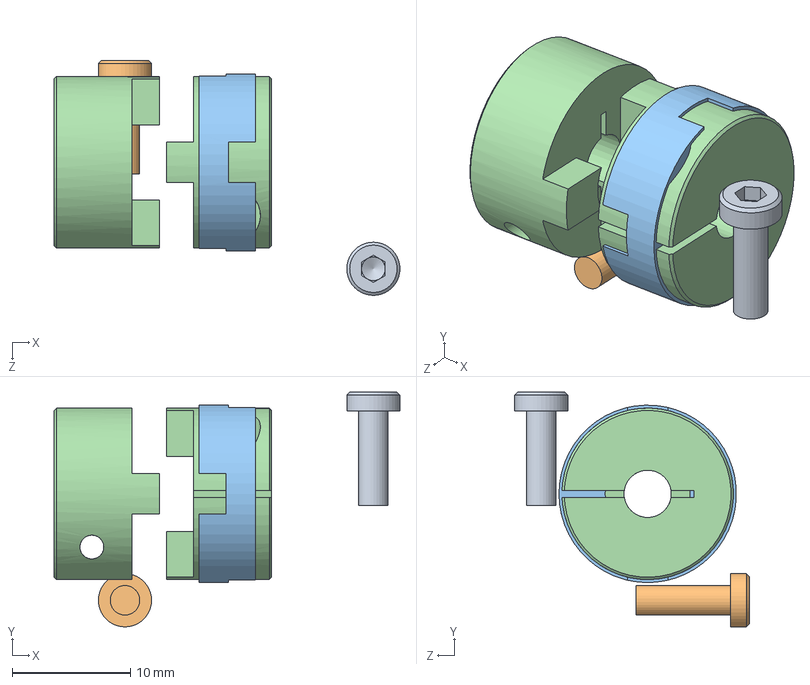
[picture p52: CAD file, 2024-06-16]
SW/Assemble/Shaft_connection.SLDASM
29.2 x 19.8 x 19.8 mm
Shaft_connection_part2
Shaft_connection_part6
Shaft_connection_part4
Shaft_connection_part1
