XianleZeng/Project-in-Design-2024/SW/Elevator/Assem.SLDASM

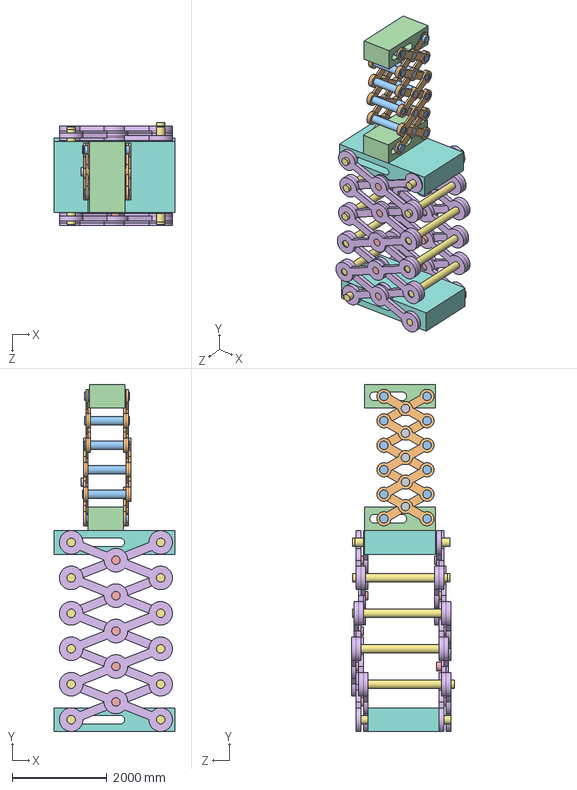
[picture p53: CAD file, 2024-06-16]
SW/Elevator/Assem.SLDASM
2550.0 x 7328.4 x 2175.0 mm
Base_12m x 2
Long_Pin_12m x 12
Bar_12m x 20
Pin_12m x 10
Base_6m x 2
Long_Pin_6m x 12
Bar_6m x 20
Pin_6m x 10
