XianleZeng/Project-in-Design-2024/SW/Elevator/Elevator12m/Elevator_12m.SLDASM

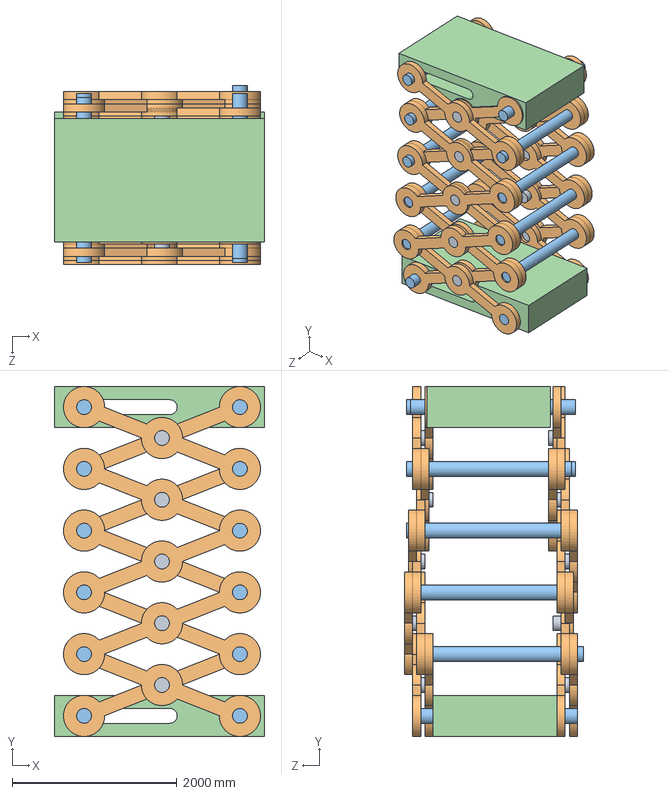
[picture p55: CAD file, 2024-06-16]
SW/Elevator/Elevator12m/Elevator_12m.SLDASM
2550.0 x 4242.8 x 2175.0 mm
Base_12m x 2
Long_Pin_12m x 12
Bar_12m x 20
Pin_12m x 10
