XianleZeng/Project-in-Design-2024/SW/Elevator/Elevator8m/Elevator_6m.SLDASM

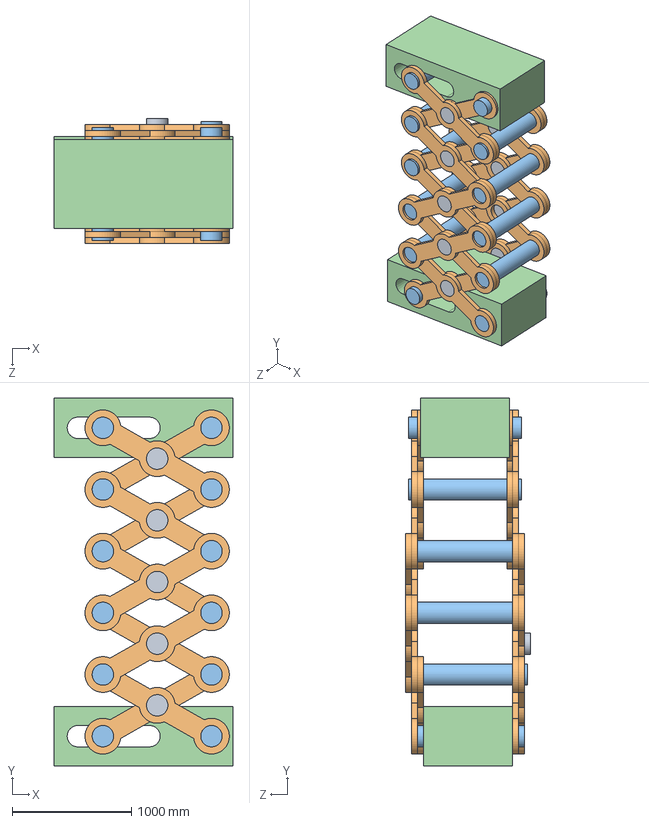
[picture p56: CAD file, 2024-06-16]
SW/Elevator/Elevator8m/Elevator_6m.SLDASM
1500.0 x 3085.6 x 1050.0 mm
Base_6m x 2
Long_Pin_6m x 12
Bar_6m x 20
Pin_6m x 10
