XianleZeng/Project-in-Design-2024/SW/Bearing/Box/CAD 6201 Deep groove ball bearings SKF/skf_bearing_6201_2_01.SLDPRT

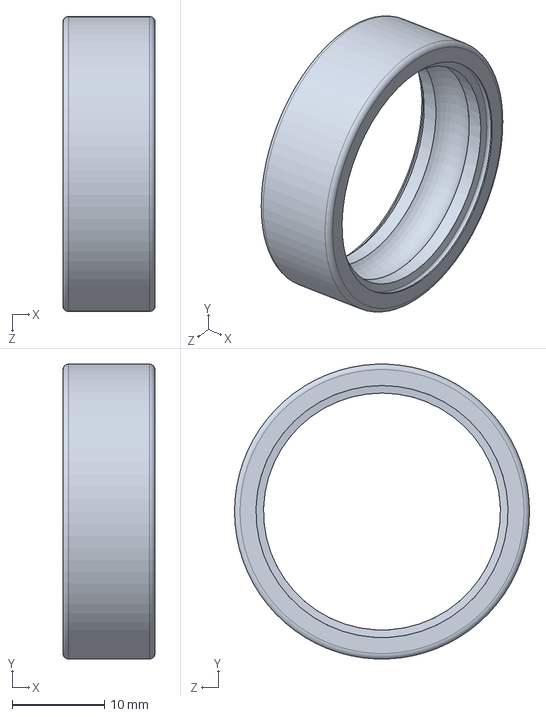
[picture p57: CAD file, 2024-06-12]
SW/Bearing/Box/CAD 6201 Deep groove ball bearings SKF/skf_bearing_6201_2_01.SLDPRT
10.0 x 32.0 x 32.0 mm
