XianleZeng/Project-in-Design-2024/SW/Box and Lid Combination/Box and Lid Combination - Final Version.STEP

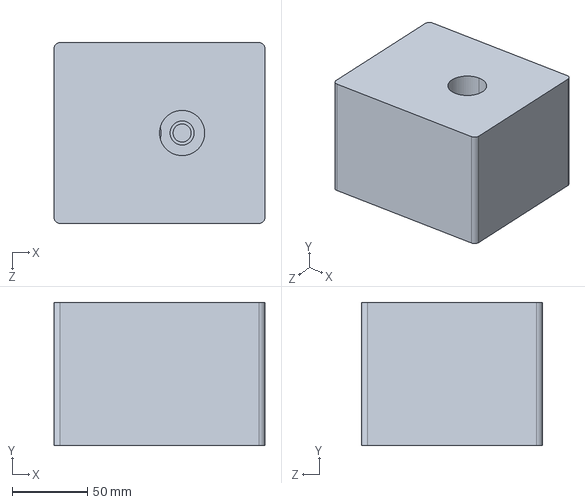
[picture p58: CAD file, 2024-06-26]
SW/Box and Lid Combination/Box and Lid Combination - Final Version.STEP
140.0 x 95.0 x 120.0 mm
