XianleZeng/Project-in-Design-2024/SW/Coupling/Shaft_connection_part2.sldprt

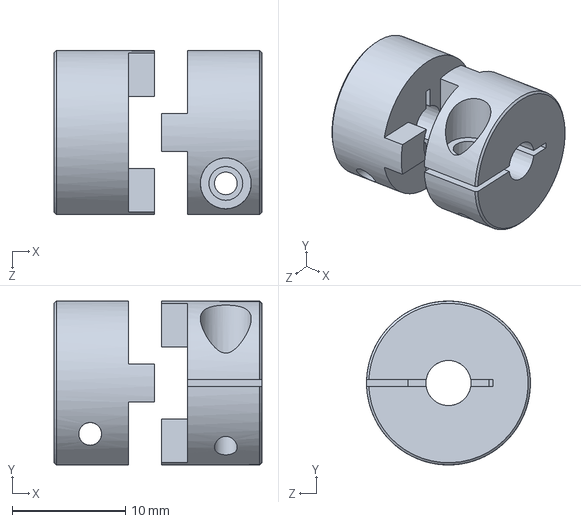
[picture p59: CAD file, 2024-06-16]
SW/Coupling/Shaft_connection_part2.sldprt
18.4 x 14.5 x 14.5 mm
