XianleZeng/Project-in-Design-2024/SW/Durain container/Beam for Pipe.SLDPRT

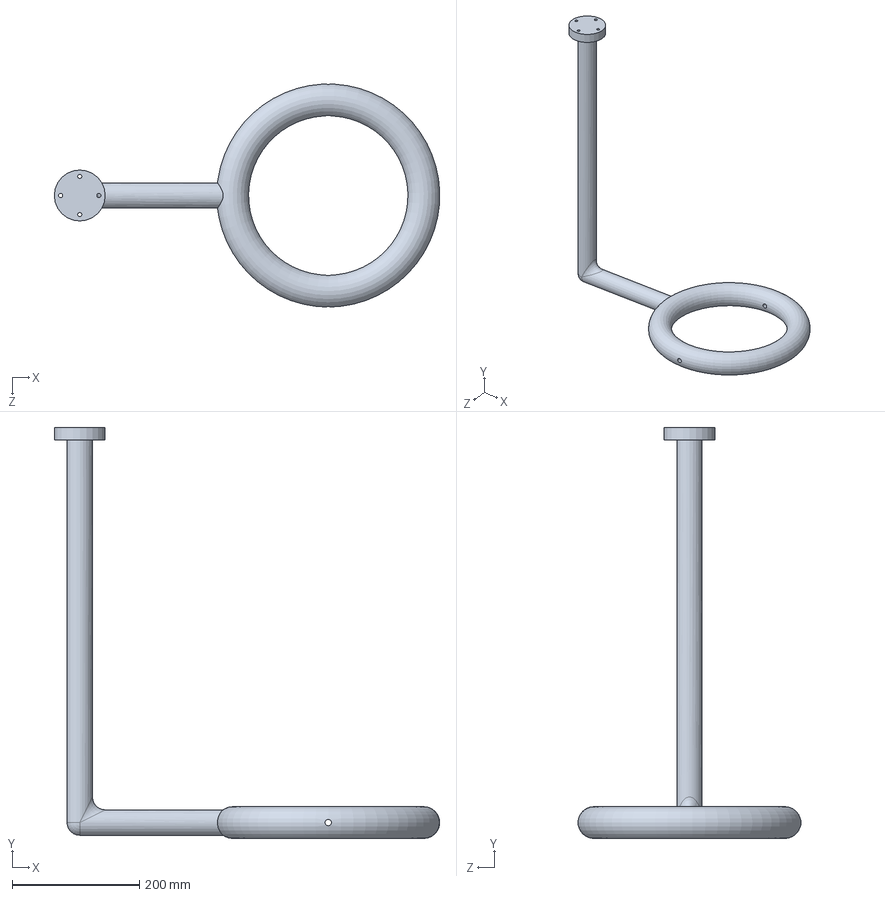
[picture p60: CAD file, 2024-06-16]
SW/Durain container/Beam for Pipe.SLDPRT
604.9 x 645.0 x 349.9 mm
