XianleZeng/Project-in-Design-2024/SW/Elevator/Elevator12m/Long_Pin_12m.SLDPRT

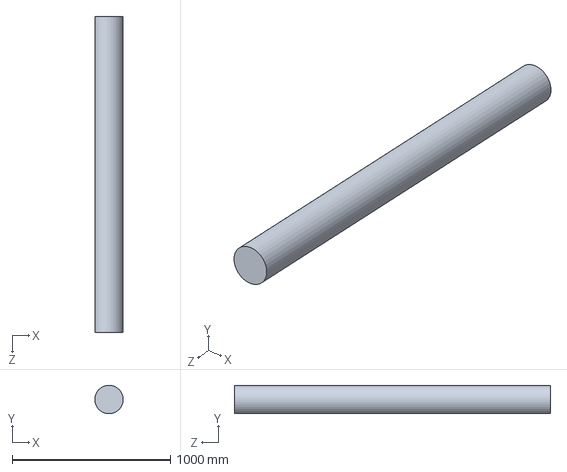
[picture p61: CAD file, 2024-06-16]
SW/Elevator/Elevator12m/Long_Pin_12m.SLDPRT
180.0 x 179.2 x 2000.0 mm
