XianleZeng/Project-in-Design-2024/SW/Elevator/Elevator8m/Pin_6m.SLDPRT

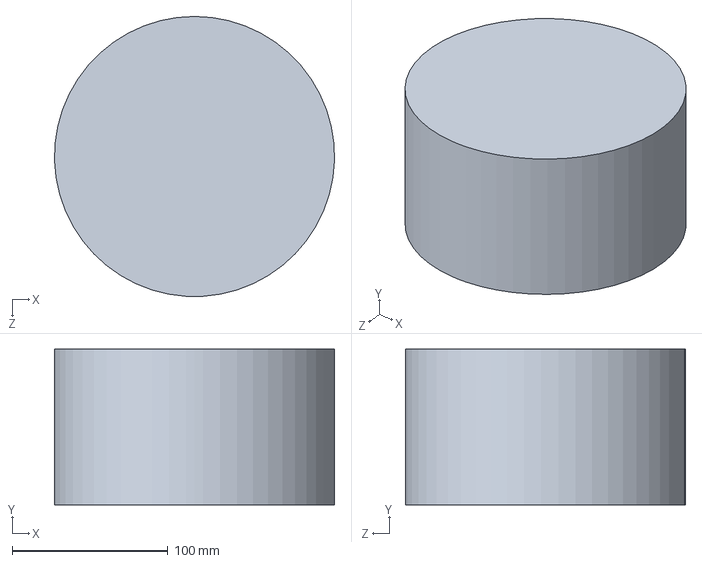
[picture p62: CAD file, 2024-06-16]
SW/Elevator/Elevator8m/Pin_6m.SLDPRT
179.9 x 100.0 x 180.0 mm
