XianleZeng/Project-in-Design-2024/SW/Flange/End Effector Motor Flange.SLDPRT

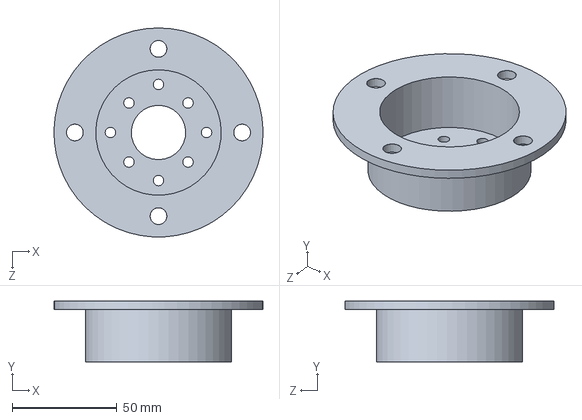
[picture p63: CAD file, 2024-06-16]
SW/Flange/End Effector Motor Flange.SLDPRT
100.0 x 29.0 x 100.0 mm
