XianleZeng/Project-in-Design-2024/SW/Gearbox/gear_box.SLDPRT

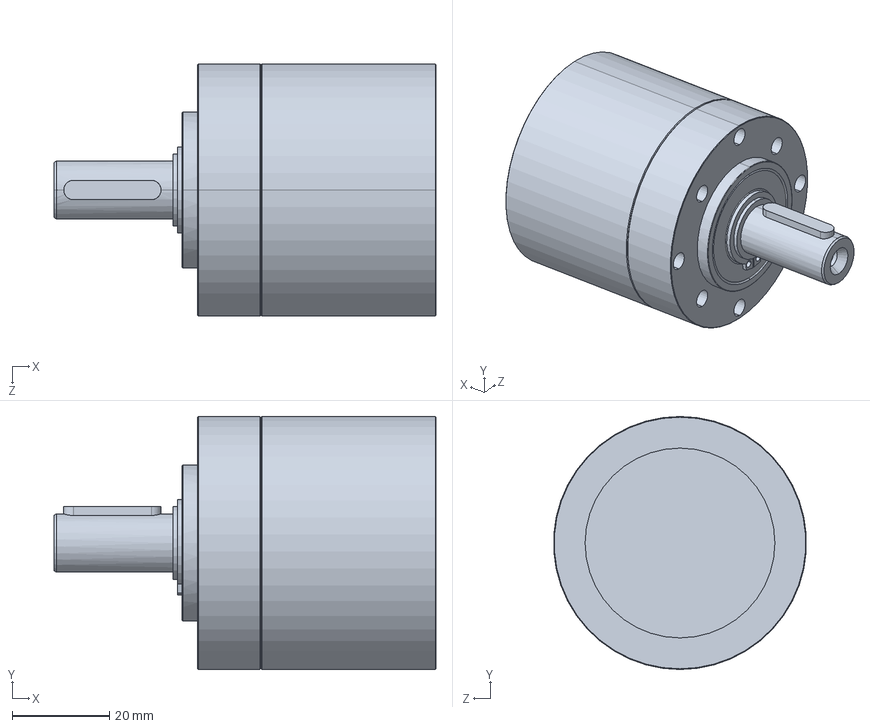
[picture p64: CAD file, 2024-05-19]
SW/Gearbox/gear_box.SLDPRT
78.5 x 52.0 x 51.9 mm
