XianleZeng/Project-in-Design-2024/SW/Motor/Motor.SLDPRT

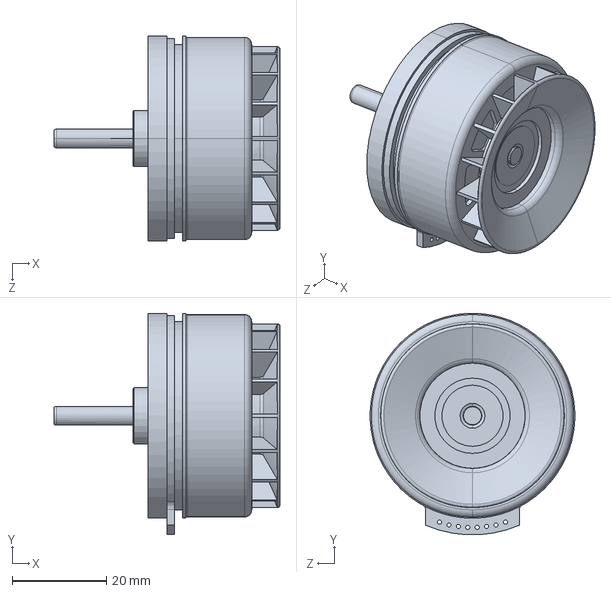
[picture p65: CAD file, 2024-05-19]
SW/Motor/Motor.SLDPRT
48.0 x 47.0 x 43.5 mm
