XianleZeng/Project-in-Design-2024/SW/Scissor/Scissor.SLDPRT

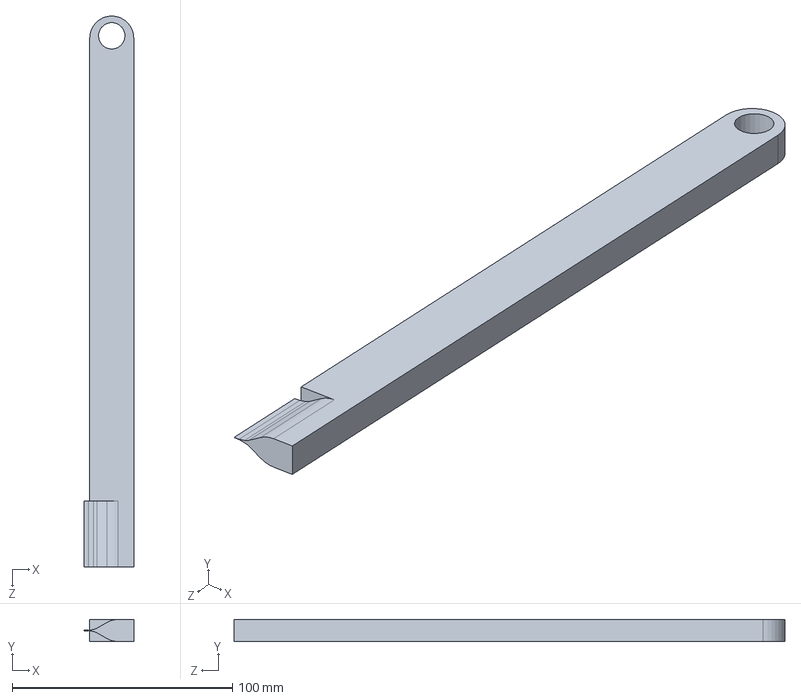
[picture p66: CAD file, 2024-06-14]
SW/Scissor/Scissor.SLDPRT
22.5 x 10.0 x 250.0 mm
