XianleZeng/Project-in-Design-2024/SW/Assemble/skf_bearing_6201_2_02.SLDPRT

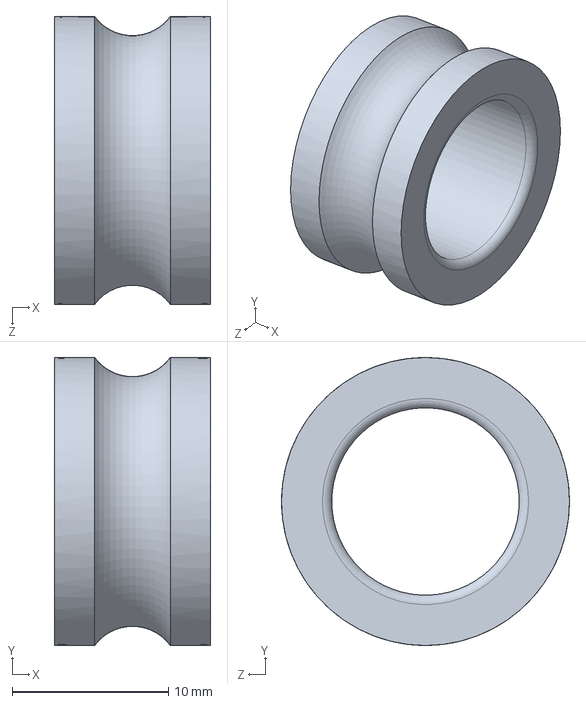
[picture p67: CAD file, 2024-06-16]
SW/Assemble/skf_bearing_6201_2_02.SLDPRT
10.0 x 18.4 x 18.4 mm
