XianleZeng/Project-in-Design-2024/SW/Bearing/Box/CAD 6201 Deep groove ball bearings SKF/skf_bearing_6201_2_03.SLDPRT

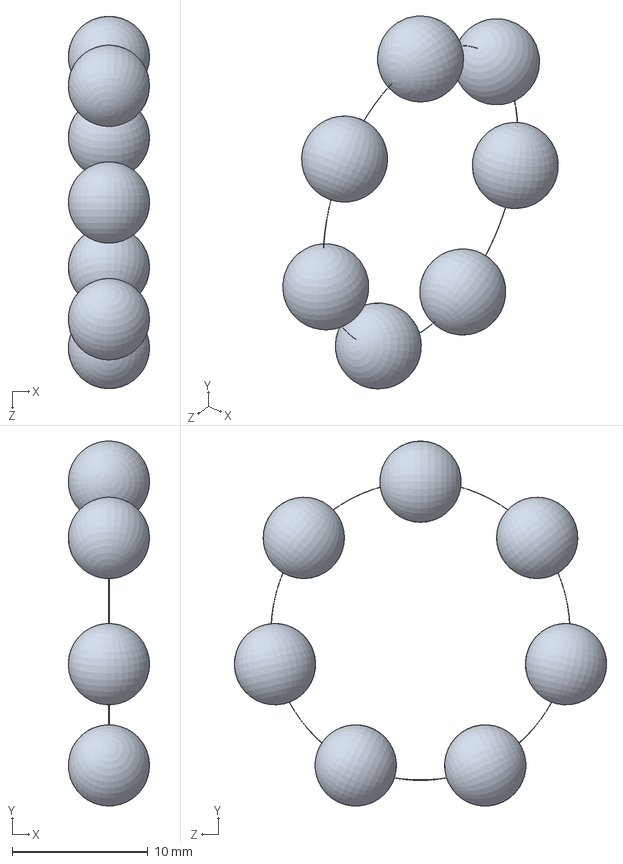
[picture p68: CAD file, 2024-06-12]
SW/Bearing/Box/CAD 6201 Deep groove ball bearings SKF/skf_bearing_6201_2_03.SLDPRT
5.99 x 26.9 x 27.4 mm
