XianleZeng/Project-in-Design-2024/SW/Box and Lid Combination/Lid.SLDPRT

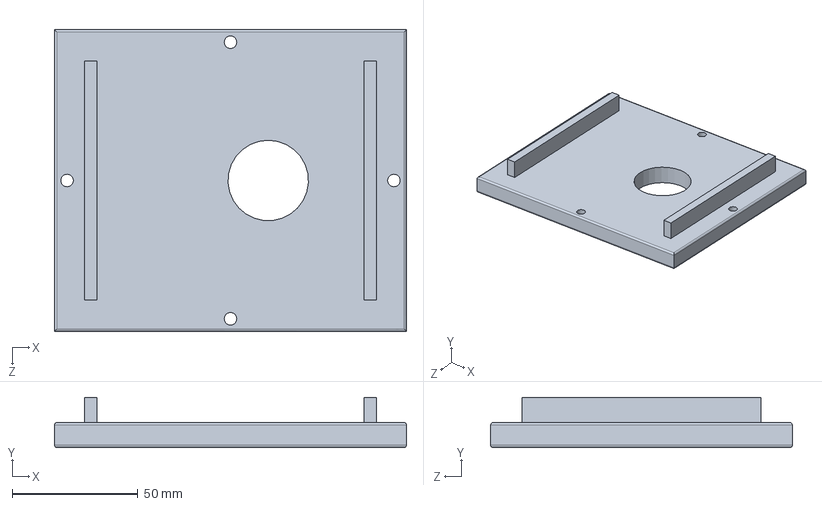
[picture p69: CAD file, 2024-06-13]
SW/Box and Lid Combination/Lid.SLDPRT
140.0 x 20.0 x 120.0 mm
