XianleZeng/Project-in-Design-2024/SW/Coupling/Shaft_connection_part6.sldprt

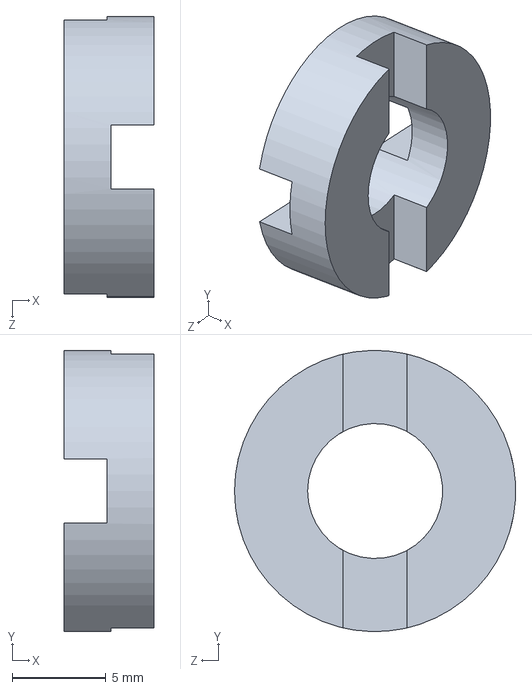
[picture p70: CAD file, 2024-06-16]
SW/Coupling/Shaft_connection_part6.sldprt
4.80 x 15.0 x 15.0 mm
