XianleZeng/Project-in-Design-2024/SW/Durain container/Pipe.SLDPRT

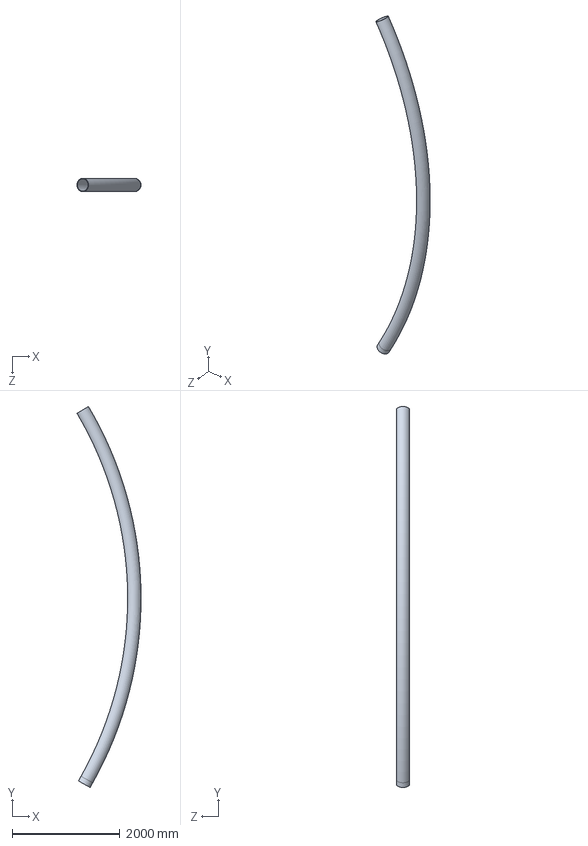
[picture p71: CAD file, 2024-06-16]
SW/Durain container/Pipe.SLDPRT
1192.3 x 7087.2 x 250.0 mm
