XianleZeng/Project-in-Design-2024/SW/Elevator/Bar_12m.SLDPRT

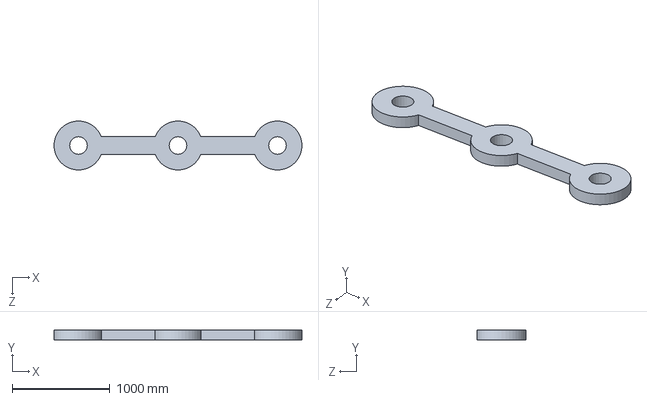
[picture p72: CAD file, 2024-06-16]
SW/Elevator/Bar_12m.SLDPRT
2532.5 x 100.0 x 500.0 mm
