XianleZeng/Project-in-Design-2024/SW/Elevator/Elevator12m/Pin_12m.SLDPRT

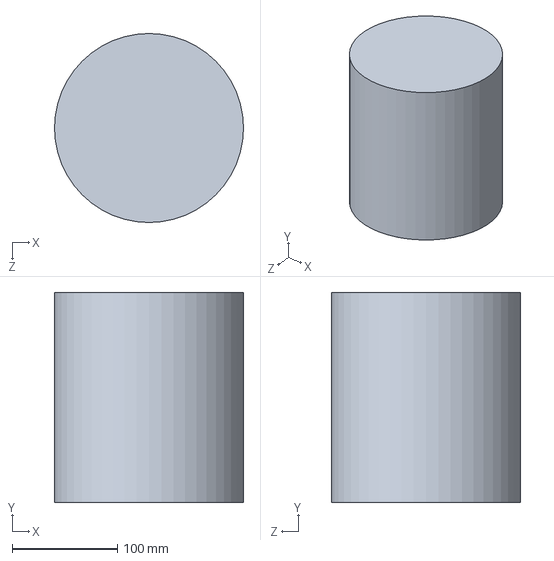
[picture p73: CAD file, 2024-06-16]
SW/Elevator/Elevator12m/Pin_12m.SLDPRT
180.0 x 200.0 x 180.0 mm
