XianleZeng/Project-in-Design-2024/SW/Elevator/Elevator8m/Long_Pin_6m.SLDPRT

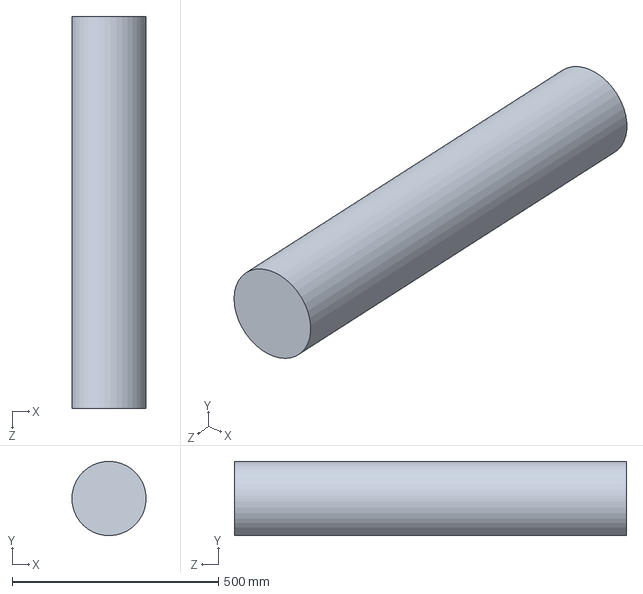
[picture p74: CAD file, 2024-06-16]
SW/Elevator/Elevator8m/Long_Pin_6m.SLDPRT
180.0 x 179.9 x 950.0 mm
