XianleZeng/Project-in-Design-2024/SW/Motor/CAD-EC-Flat-60-100W/EC60fl-100W-V2.stp

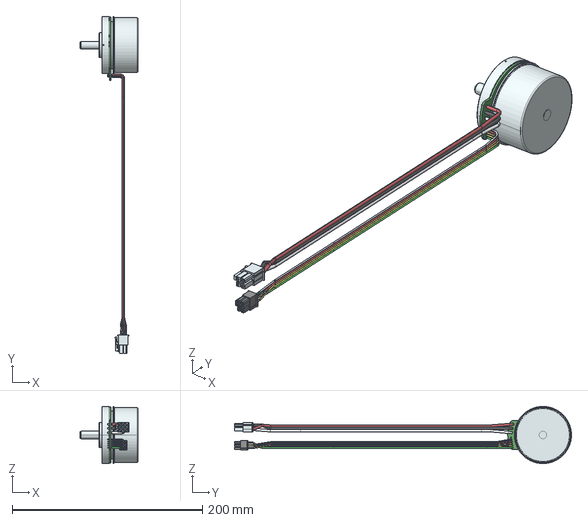
[picture p75: CAD file, 2024-05-25]
SW/Motor/CAD-EC-Flat-60-100W/EC60fl-100W-V2.stp
61.3 x 353.9 x 60.0 mm
