XianleZeng/Project-in-Design-2024/SW/Scissor/Scissor-LAPTOP-6C8MKIMP.SLDPRT

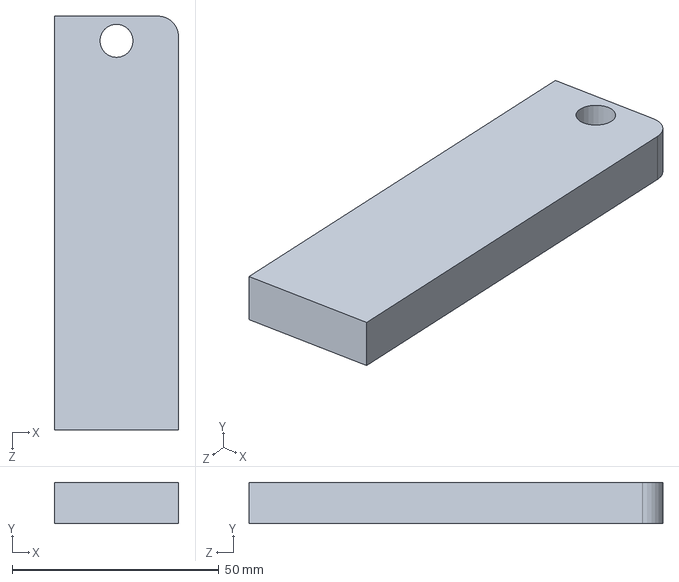
[picture p76: CAD file, 2024-05-19]
SW/Scissor/Scissor-LAPTOP-6C8MKIMP.SLDPRT
30.0 x 10.0 x 100.0 mm
