XianleZeng/Project-in-Design-2024/SW/Assemble/Shaft_connection_part1.sldprt

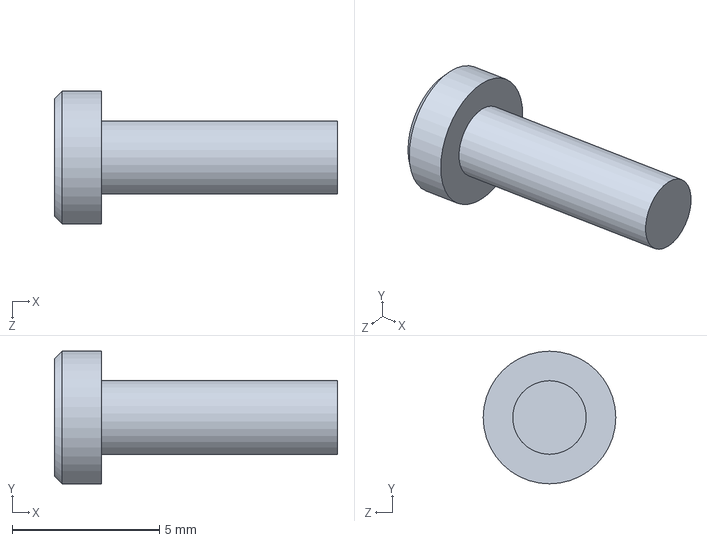
[picture p77: CAD file, 2024-06-16]
SW/Assemble/Shaft_connection_part1.sldprt
9.60 x 4.50 x 4.50 mm
