XianleZeng/Project-in-Design-2024/SW/Box and Lid Combination/Box.SLDPRT

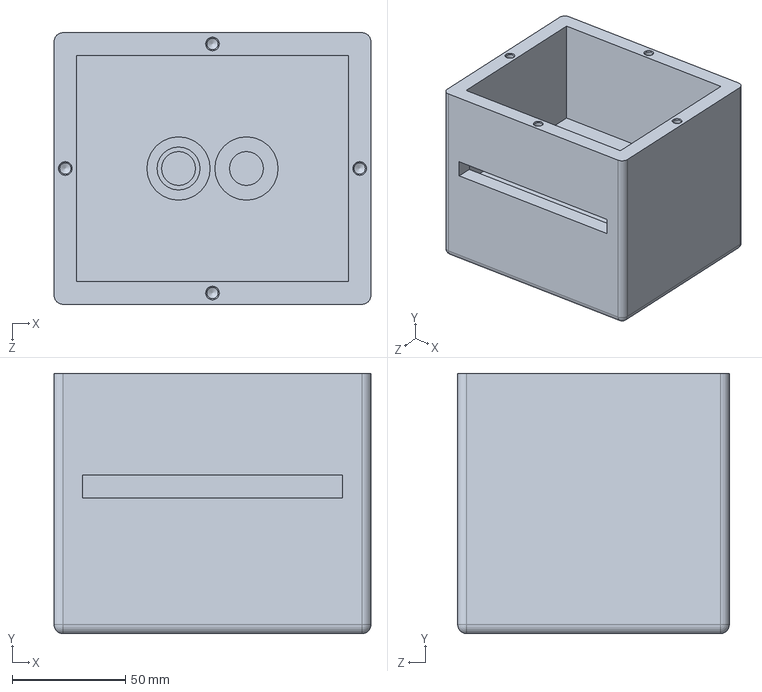
[picture p78: CAD file, 2024-06-01]
SW/Box and Lid Combination/Box.SLDPRT
140.0 x 115.0 x 120.0 mm
