XianleZeng/Project-in-Design-2024/SW/Elevator/Elevator12m/Base_12m.SLDPRT

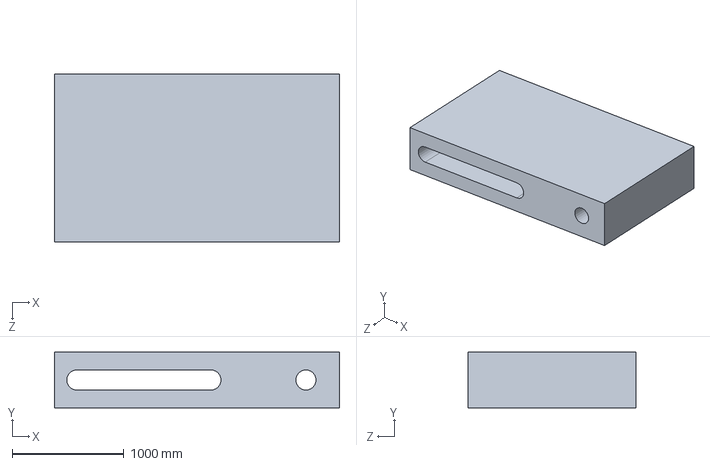
[picture p79: CAD file, 2024-06-16]
SW/Elevator/Elevator12m/Base_12m.SLDPRT
2550.0 x 500.0 x 1500.0 mm
