XianleZeng/Project-in-Design-2024/SW/Elevator/Elevator8m/Base_6m.SLDPRT

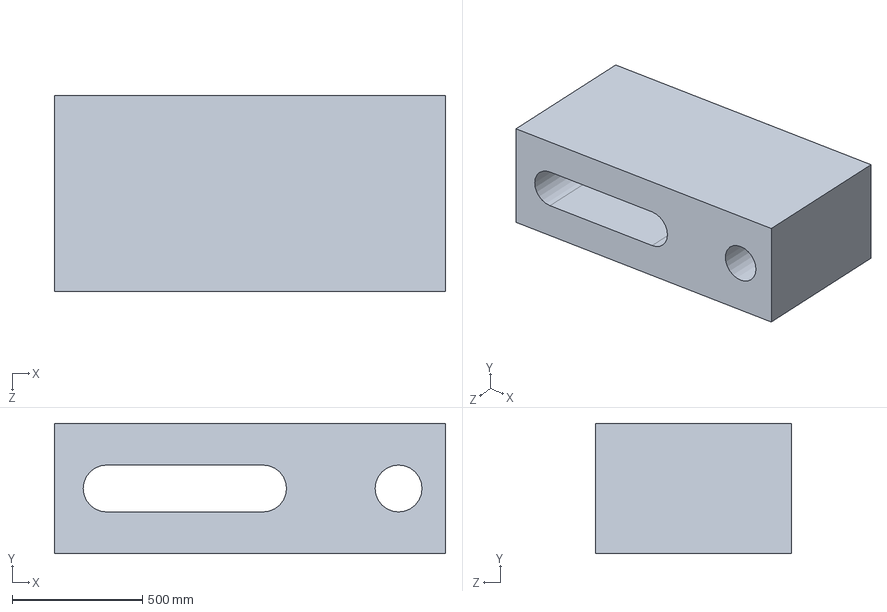
[picture p80: CAD file, 2024-06-16]
SW/Elevator/Elevator8m/Base_6m.SLDPRT
1500.0 x 500.0 x 750.0 mm
