XianleZeng/Project-in-Design-2024/SW/Elevator/Elevator8m/Bar_6m.SLDPRT

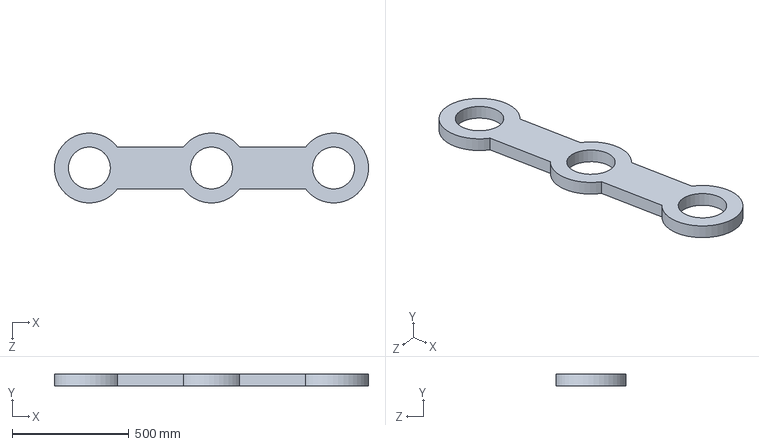
[picture p81: CAD file, 2024-06-16]
SW/Elevator/Elevator8m/Bar_6m.SLDPRT
1346.2 x 50.0 x 299.9 mm
