XianleZeng/Project-in-Design-2024/SW/Assemble/Beam for Pipe.SLDPRT

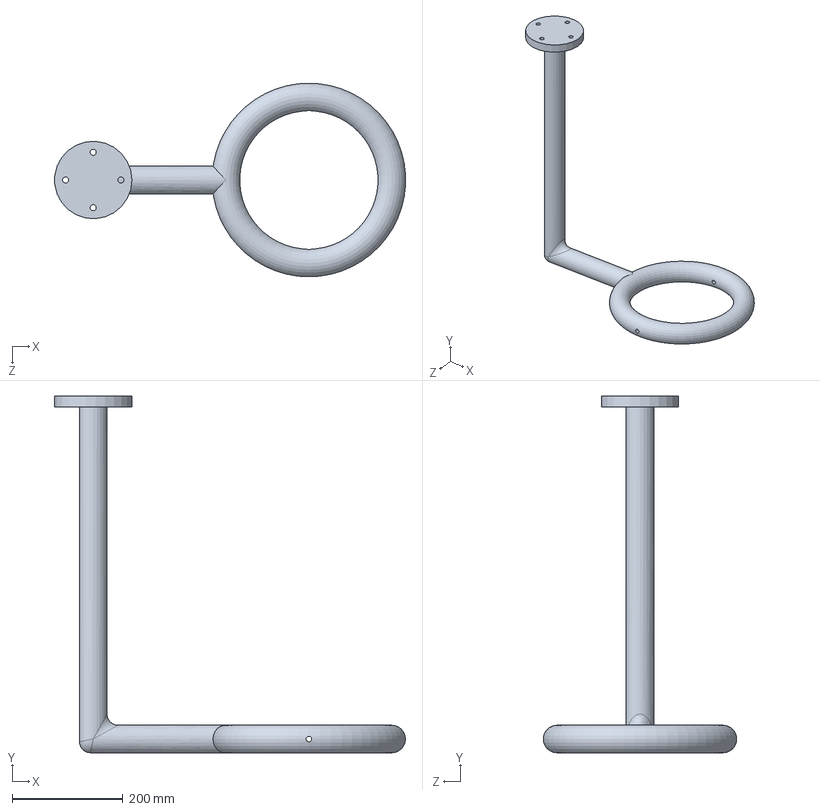
[picture p82: CAD file, 2024-06-16]
SW/Assemble/Beam for Pipe.SLDPRT
634.7 x 645.0 x 349.9 mm
