XianleZeng/Project-in-Design-2024/SW/Assemble/Pipe.SLDPRT

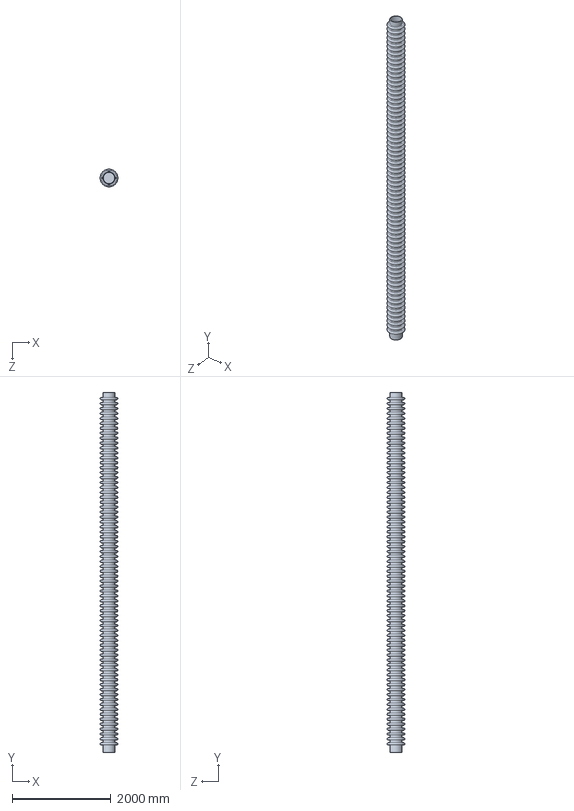
[picture p83: CAD file, 2024-06-16]
SW/Assemble/Pipe.SLDPRT
359.0 x 7300.0 x 360.0 mm
