XianleZeng/Project-in-Design-2024/SW/Assemble/Beam.SLDPRT

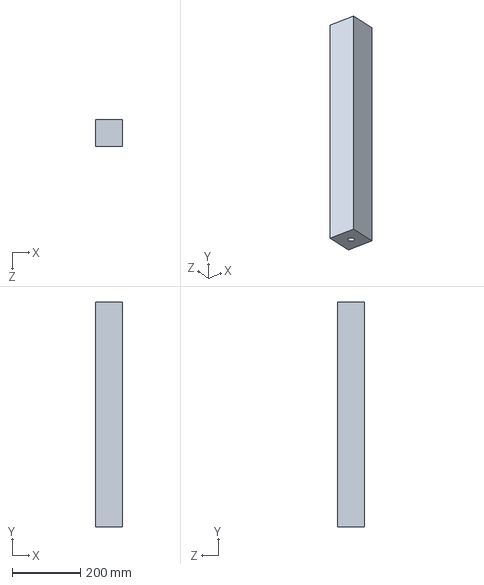
[picture p84: CAD file, 2024-06-16]
SW/Assemble/Beam.SLDPRT
80.0 x 660.0 x 80.0 mm
