XianleZeng/Project-in-Design-2024/SW/Assemble/Box.SLDPRT

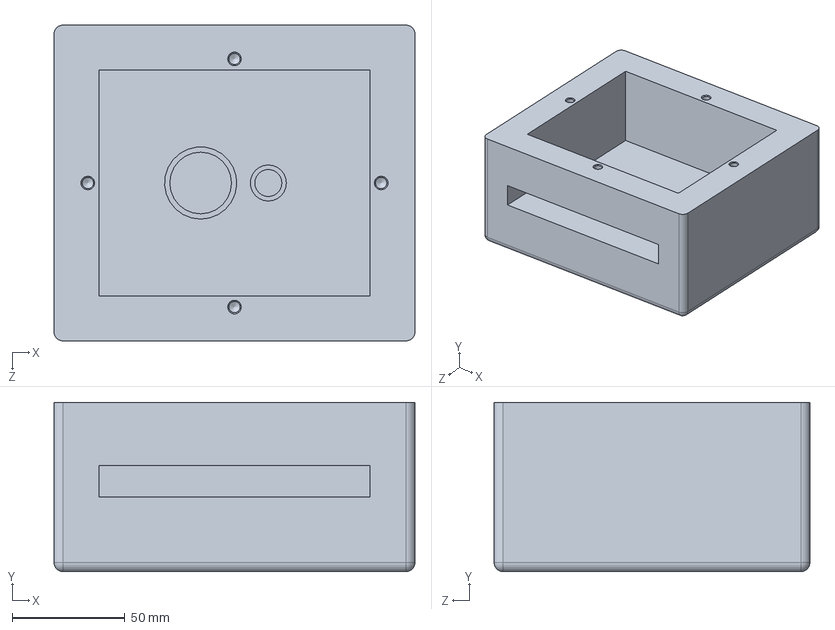
[picture p85: CAD file, 2024-06-16]
SW/Assemble/Box.SLDPRT
160.0 x 75.0 x 140.0 mm
