XianleZeng/Project-in-Design-2024/SW/Assemble/BOX_LID_SOLIDWORKS_FEA.SLDPRT

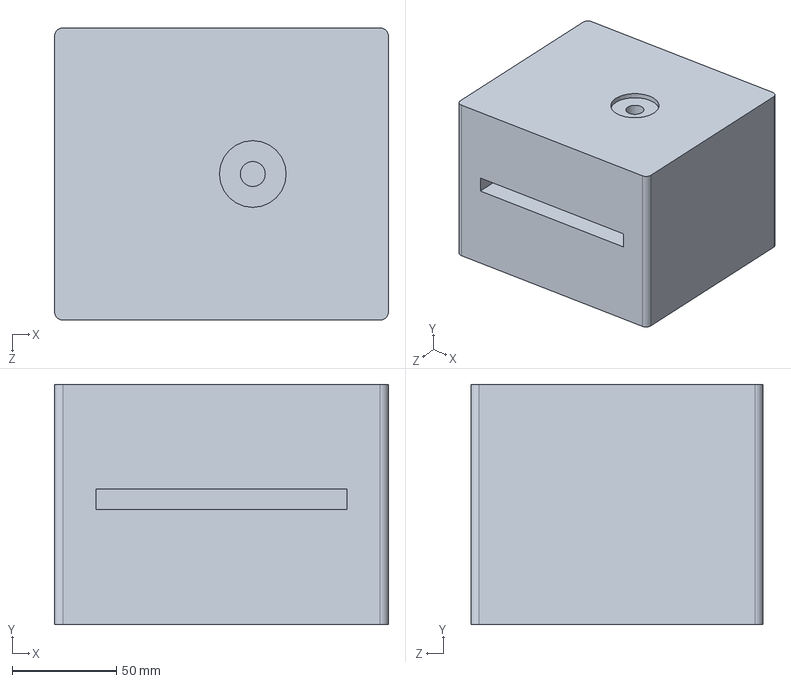
[picture p86: CAD file, 2024-06-16]
SW/Assemble/BOX_LID_SOLIDWORKS_FEA.SLDPRT
160.0 x 115.0 x 140.0 mm
