XianleZeng/Project-in-Design-2024/SW/Assemble/Shaft_Design_R.SLDPRT

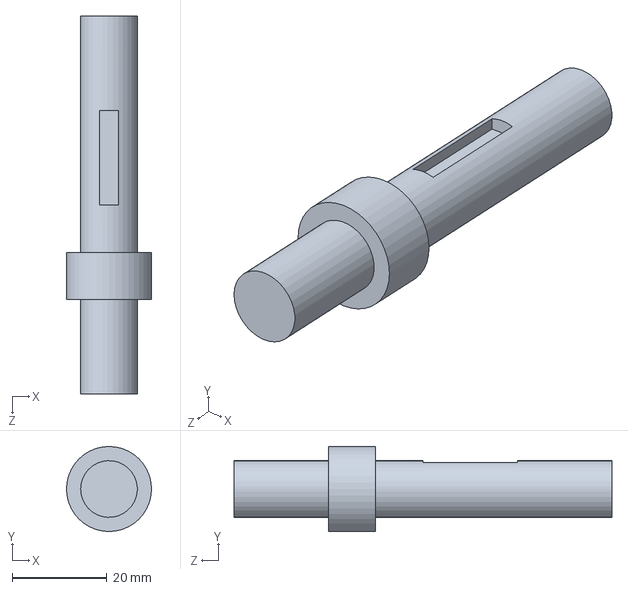
[picture p87: CAD file, 2024-06-16]
SW/Assemble/Shaft_Design_R.SLDPRT
18.0 x 18.0 x 80.0 mm
