XianleZeng/Project-in-Design-2024/SW/Assemble/Final_GEAKB2.0-15-20-A-12N.SLDPRT

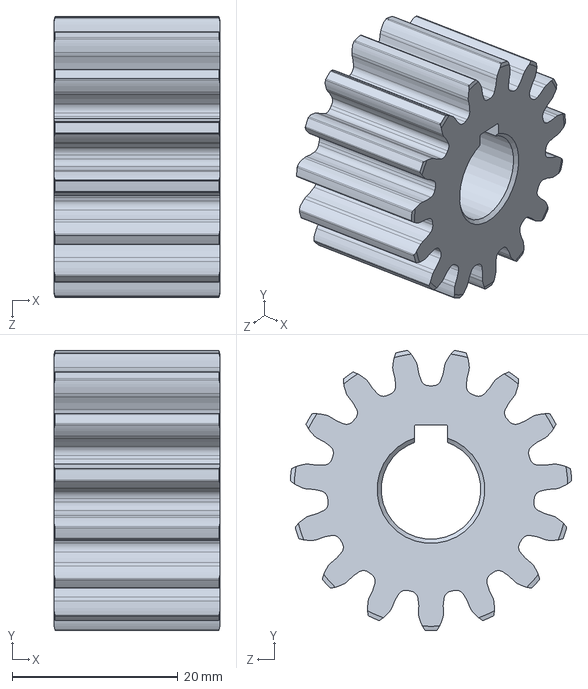
[picture p88: CAD file, 2024-06-16]
SW/Assemble/Final_GEAKB2.0-15-20-A-12N.SLDPRT
20.0 x 33.7 x 33.9 mm
