XianleZeng/Project-in-Design-2024/SW/Assemble/Scissor.SLDPRT

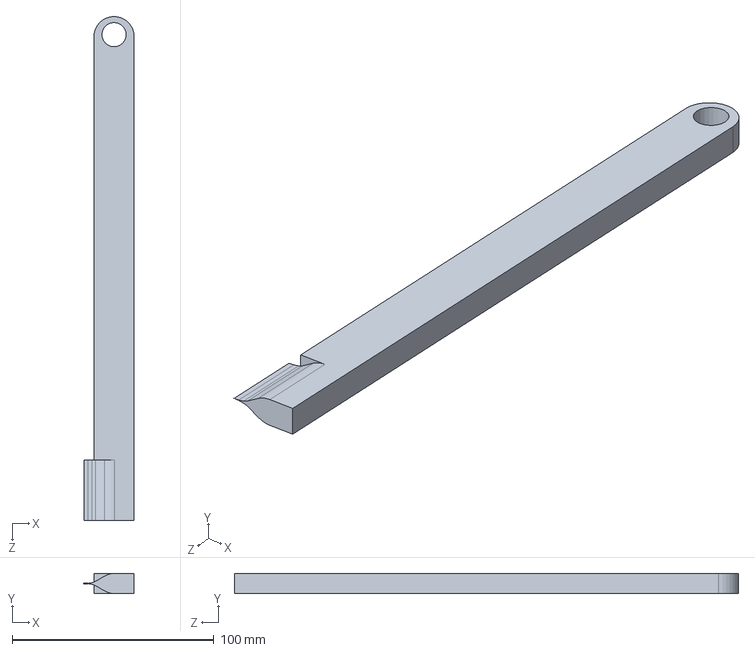
[picture p89: CAD file, 2024-06-16]
SW/Assemble/Scissor.SLDPRT
25.0 x 10.0 x 250.0 mm
