XianleZeng/Project-in-Design-2024/SW/Assemble/Beam_2.SLDPRT

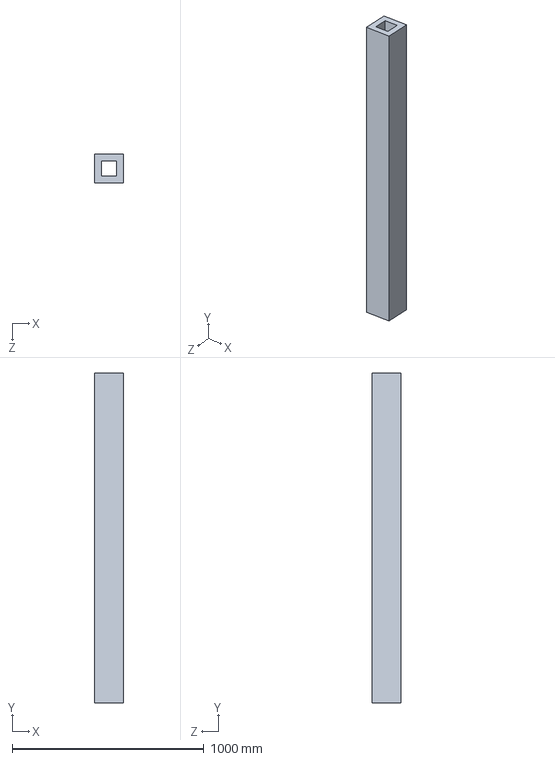
[picture p90: CAD file, 2024-06-16]
SW/Assemble/Beam_2.SLDPRT
150.0 x 1720.0 x 150.0 mm
