XianleZeng/Project-in-Design-2024/SW/Assemble/Lid.SLDPRT

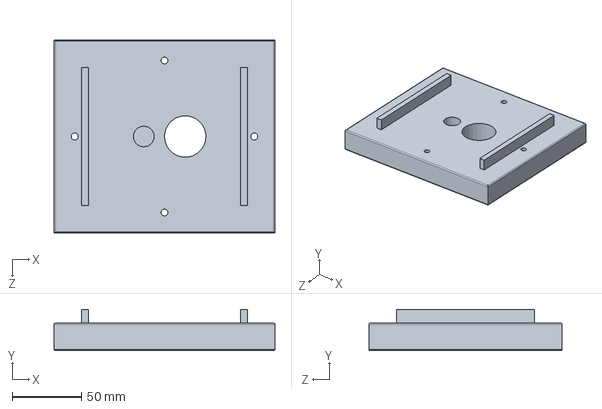
[picture p91: CAD file, 2024-06-16]
SW/Assemble/Lid.SLDPRT
160.0 x 30.0 x 140.0 mm
