XianleZeng/Project-in-Design-2024/SW/Assemble/String.SLDPRT

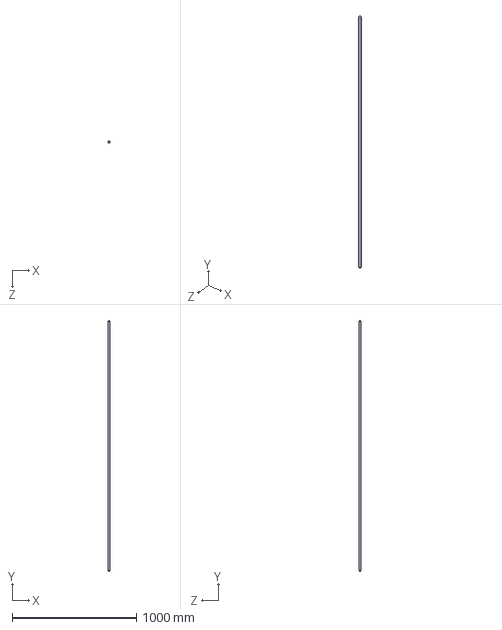
[picture p92: CAD file, 2024-06-16]
SW/Assemble/String.SLDPRT
18.0 x 2018.0 x 18.0 mm
