XianleZeng/Project-in-Design-2024/SW/Assemble/KEY.SLDPRT

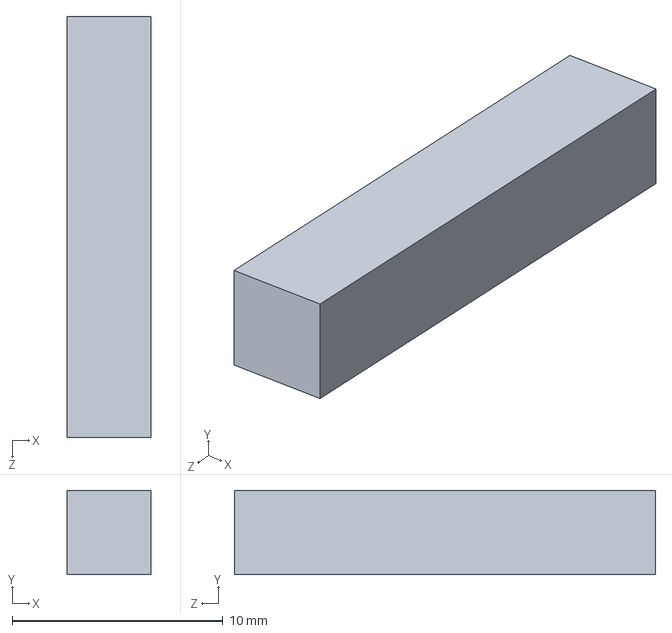
[picture p93: CAD file, 2024-06-14]
SW/Assemble/KEY.SLDPRT
4.00 x 4.00 x 20.0 mm
