XianleZeng/Project-in-Design-2024/SW/Assemble/Assem.SLDASM

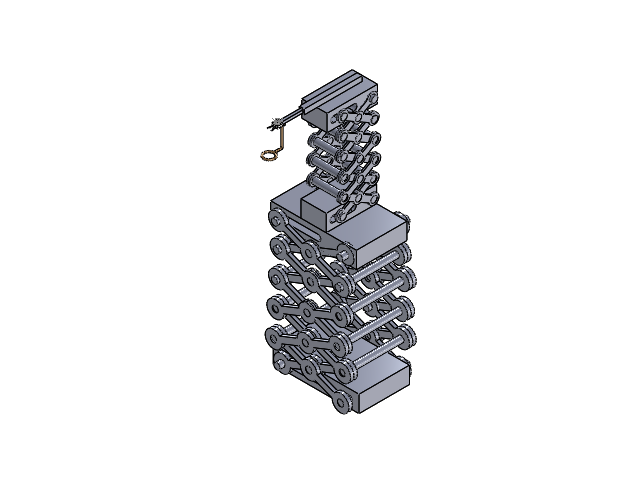
[picture p94: CAD file, 2024-06-16]
SW/Assemble/Assem.SLDASM
Base_12m x 2
Long_Pin_12m x 12
Bar_12m x 20
Pin_12m x 10
Base_6m x 2
Long_Pin_6m x 12
Bar_6m x 20
Pin_6m x 10
Lid
Shaft_Design_R x 2
Final_GEAKB2.0-15-20-A-12N x 2
skf_bearing_6201_2_01
skf_bearing_6201_2_02
skf_bearing_6201_2_03
SKF_HK 1210 E_PART1 x 2
SKF_HK 1210 E_PART2 x 36
SKF_HK 1210 E_PART3 x 36
KEY x 2
Scissor x 2
Motor x 2
gear_box x 2
Beam
Beam_2
Power_screw_part4
Power_screw_part3
Shaft_connection_part2 x 2
Shaft_connection_part6 x 2
Shaft_connection_part4 x 2
Shaft_connection_part1 x 2
Beam for Pipe
