XianleZeng/Project-in-Design-2024/(list of files, cad)

Other CAD files:
SW/Bearing/Box/CAD HK 1210 E Needle roller bearings SKF/SOLIDWORKS/SKF_HK 1210 E.sldasm
SW/Assemble/skf_bearing_6201_2.SLDASM
SW/Assemble/SKF_HK 1210 E.sldasm
SW/Bearing/Box/CAD HK 1210 E Needle roller bearings SKF/SOLIDWORKS/SKF_HK 1210 E_PART3.sldprt
SW/Bearing/Box/CAD 6201 Deep groove ball bearings SKF/skf_bearing_6201_2_02.SLDPRT
SW/Bearing/Box/CAD HK 1210 E Needle roller bearings SKF/SOLIDWORKS/SKF_HK 1210 E_PART2.sldprt
SW/Coupling/Shaft_connection_part4.sldprt
SW/Assemble/Shaft_connection_part3.sldprt
SW/Bearing/Box/CAD HK 1210 E Needle roller bearings SKF/SOLIDWORKS/SKF_HK 1210 E_PART1.sldprt
SW/Coupling/Shaft_connection_part3.sldprt
SW/Coupling/Shaft_connection_part5.sldprt
SW/Assemble/SKF_HK 1210 E_PART2.sldprt
SW/Assemble/SKF_HK 1210 E_PART1.sldprt
SW/Assemble/Shaft_connection_part5.sldprt
SW/Assemble/Shaft_connection_part4.sldprt
SW/Assemble/skf_bearing_6201_2_01.SLDPRT
SW/Assemble/SKF_HK 1210 E_PART3.sldprt
SW/Assemble/skf_bearing_6201_2_03.SLDPRT
SW/Assemble/Power_Screw_housing.SLDASM
SW/Assemble/Power_Screw_housing_part1.sldprt
SW/Assemble/Power_Screw_housing_part2.sldprt
SW/Assemble/Power_Screw_housing_part3.sldprt
SW/Assemble/Power_Screw_housing_part4.sldprt
SW/Assemble/Power_screw.SLDASM
SW/Assemble/Power_screw_part1.sldprt
SW/Assemble/Power_screw_part2.sldprt
SW/Assemble/Power_screw_part3.sldprt
SW/Assemble/Power_screw_part4.sldprt
SW/Box and Lid Combination/Box and Lid Combination - Final Version.SLDPRT
SW/Gearbox/223080-223083-223089-223097/223080_GP52C-1st.stp
SW/Gearbox/223080-223083-223089-223097/223083_GP52C-2st.stp
SW/Gearbox/223080-223083-223089-223097/223089_GP52C-3st.stp
SW/Gearbox/223080-223083-223089-223097/223097_GP52C-4st.stp
SW/Motor/608139_EC45fl_90W_1WE_Kabel.stp
SW/Motor/CAD-EC-Flat-60-100W/EC60fl-100W-V1.stp
SW/Power_screw/Power_screw.SLDASM
SW/Power_screw/Power_screw_part1.sldprt
SW/Power_screw/Power_screw_part2.sldprt
SW/Power_screw/Power_screw_part3.sldprt
SW/Power_screw/Power_screw_part4.sldprt
SW/Power_screw_housing/Power_Screw_housing.SLDASM
SW/Power_screw_housing/Power_Screw_housing_part1.sldprt
SW/Power_screw_housing/Power_Screw_housing_part2.sldprt
SW/Power_screw_housing/Power_Screw_housing_part3.sldprt
SW/Power_screw_housing/Power_Screw_housing_part4.sldprt
