XianleZeng/Project-in-Design-2024/(commit log)

2024-04-12 update excel
    [lecture3_4.xlsx, project planning 1a.xlsx]
2024-04-12 add Components
    [Components.xlsx]
2024-04-12 add Documents
    [lecture3_4.xlsx]
2024-04-19 Update planning, code and purchase file(motor)
    [Components.xlsx, project planning 1a.xlsx]
2024-05-25 "Update Gear Selection for end-effector"
2024-05-25 "Update solidworks model for gear"
    [Final_GEAKB2.0-15-20-A-12N.SLDPRT]
2024-05-25 "Update dimensions of gear"
2024-05-25 Update gear document - mass information
2024-05-25 Update - Gear document
2024-05-25 Gear document update
2024-05-26 "Update Gearhead and Motor"
2024-05-26 "Update document of Gearhead and motor"
2024-05-26 Update gear selection document - Force applied to a single blade is assigned to 50N
2024-05-26 Update gear selection - Tangent force analysis
2024-05-26 "Update data sheet of gearhead and motor"
2024-05-26 project planning 1a.xlsx
    [project planning 1a.xlsx]
2024-05-28 add shaft design
2024-05-29 Update Box Solidworks File
    [Box.SLDPRT]
2024-06-01 Update Box Solidworks file - Bearing location and edge fillet modification
    [Box.SLDPRT]
2024-06-12 "Update Bearing selection"
    [SKF_HK 1210 E.sldasm, SKF_HK 1210 E_PART1.sldprt, SKF_HK 1210 E_PART2.sldprt, SKF_HK 1210 E_PART3.sldprt, skf_bearing_6201_2.SLDASM, skf_bearing_6201_2_01.SLDPRT, skf_bearing_6201_2_02.SLDPRT, skf_bearing_6201_2_03.SLDPRT]
2024-06-13 Update: BOX-LID FEA file
    [BOX_LID_SOLIDWORKS_FEA.SLDPRT, BOX_LID_SOLIDWORKS_FEA.STEP]
2024-06-13 Update: Lid file submission
    [Lid.SLDPRT]
2024-06-14 "Update SW"
    [608139_EC45fl_90W_1WE_Kabel.stp, Assem1.SLDASM, BOX_LID_SOLIDWORKS_FEA.SLDPRT, Box.SLDPRT, Final_GEAKB2.0-15-20-A-12N.SLDPRT, Gear_scissor_GEAKB2.0-15-20-A-12N.SLDPRT, KEY.SLDPRT, Lid.SLDPRT]
2024-06-15 Update - Box and Lid Combination Data Sheet
    [Box and Lid Combination Data Sheet.xlsx]
2024-06-15 Update - Box and Lid Combination Optimization - Final Version!
    [BOX_LID_SOLIDWORKS_FEA.STEP, Box and Lid Combination - Final Version.SLDPRT, Box and Lid Combination - Final Version.STEP, Box.SLDPRT, Lid.SLDPRT]
2024-06-16 Update - Durain Container SW file
    [Beam for Pipe.SLDPRT, Pipe.SLDPRT, String.SLDPRT]
2024-06-16 Update - Beam and its Pipe
    [Beam for Pipe.SLDPRT, Pipe.SLDPRT, String.SLDPRT]
2024-06-16 Update - End Effector Motor Flange
    [End Effector Motor Flange.SLDPRT]
2024-06-25 "Shaft Desgin Doc"
2024-06-25 Update Gear Selection Document
2024-06-25 Update Box and Lid Excel File
    [Box and Lid Combination Data Sheet.xlsx]
2024-06-25 Box and Lid excel file modification
    [Box and Lid Combination Data Sheet.xlsx]
2024-06-26 Update Gear Word File
2024-06-26 Update Box and Lid Combination SW and ANSYS File
    [Box and Lid Combination - Final Version.SLDPRT, Box and Lid Combination - Final Version.STEP]
2024-06-26 Update Box and Lid Combination Word Document and Datasheet
    [Box and Lid Combination Data Sheet.xlsx]
2024-06-26 Gear Selection Word File Update - Final Version
2024-06-26 Update: Final Version of Gear, Box and Lid Documents to merge into the report
